PDXECE411T12/ECE411-Project/readme.md

# ECE 411 Team 12 
## RFID Smart Lock

### Fall 2020
### Authors: Miles Breslin, Miguel Higgins Moy, John Sharpe, Noah Page
