PDXECE411T12/ECE411-Project/EagleCAD/readme.md

Schematic forked from Adafruit's wonderful ESP8266 Huzzah PCB

<https://github.com/PDXECE411T12/ECE411-RFID-Lock-Eagle>
