PDXECE411T12/ECE411-Project/Homework Deliverables/Practicum/Three Project Ideas/CatFeeder.md

# Cat Feeder

Reservoir of food that opens based on an RFID chip's proximity. This will help deter cats from eating another cat's food.

Sensor: RFID
Actuator: Servo Motor
Processor: ESP8266
