PDXECE411T12/ECE411-Project/Homework Deliverables/Practicum/Three Project Ideas/GuitarPedal.md

# Guitar Pedal

A custom processor to modulate the frequency of the sound output by a guitar.

Sensor: Potentiometers
Actuator: Sound
Controller: ESP8266
