PDXECE411T12/ECE411-Project/Homework Deliverables/BlockDiagrams.md

# System Inputs/Outputs

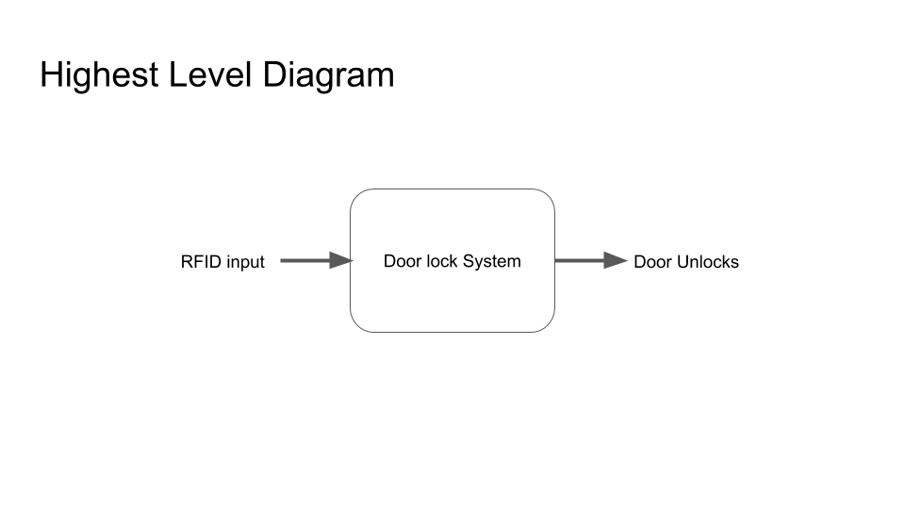
[picture p18: Homework Deliverables/imgs/BlockDiagram1.png]


# Interconnections of Subsystems

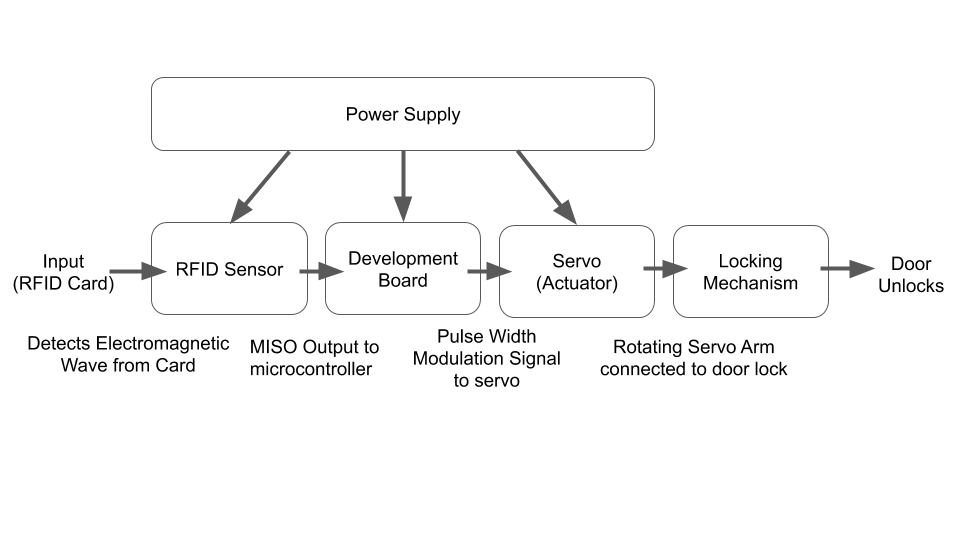
[picture p19: Homework Deliverables/imgs/BlockDiagram2.png]


# Subsystem Block Diagrams

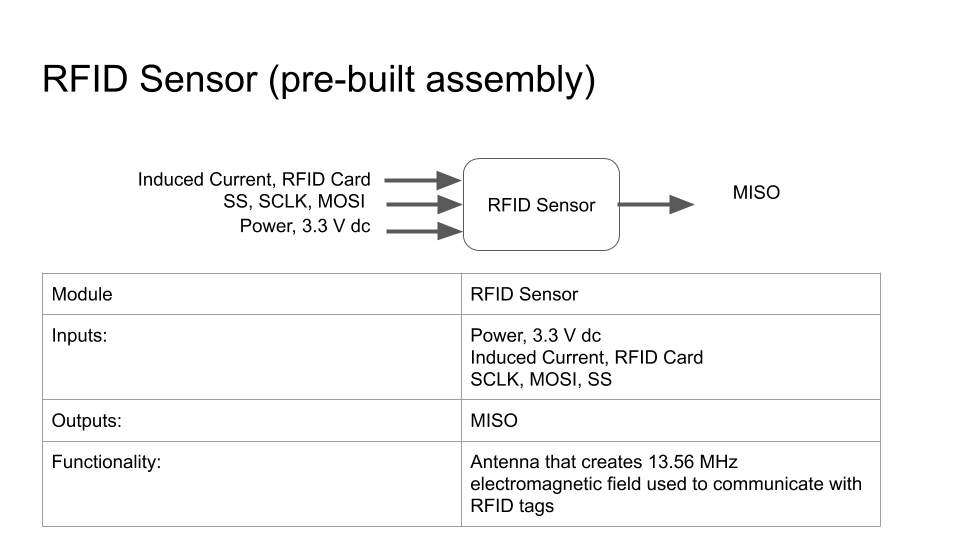
[picture p20: Homework Deliverables/imgs/BlockDiagram3.png]


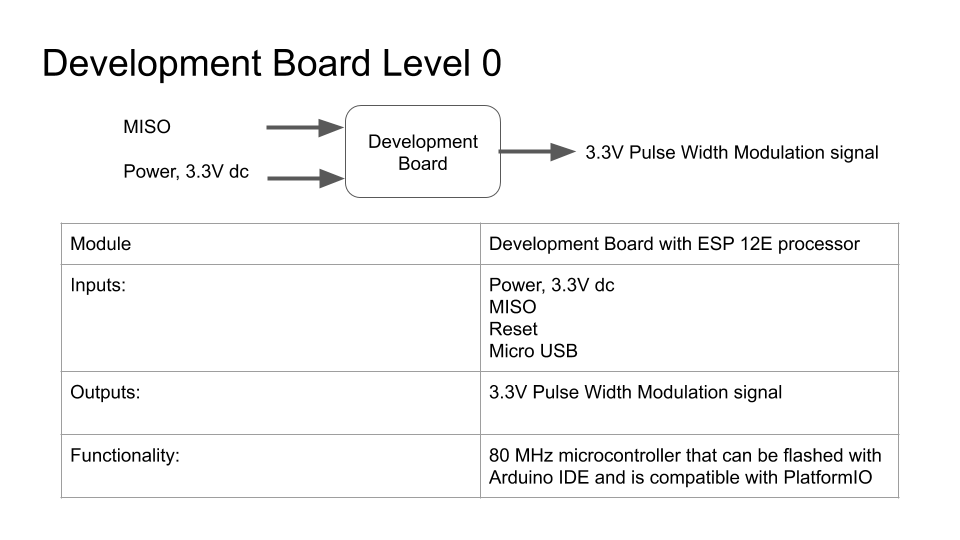
[picture p21: Homework Deliverables/imgs/BlockDiagram4.png]


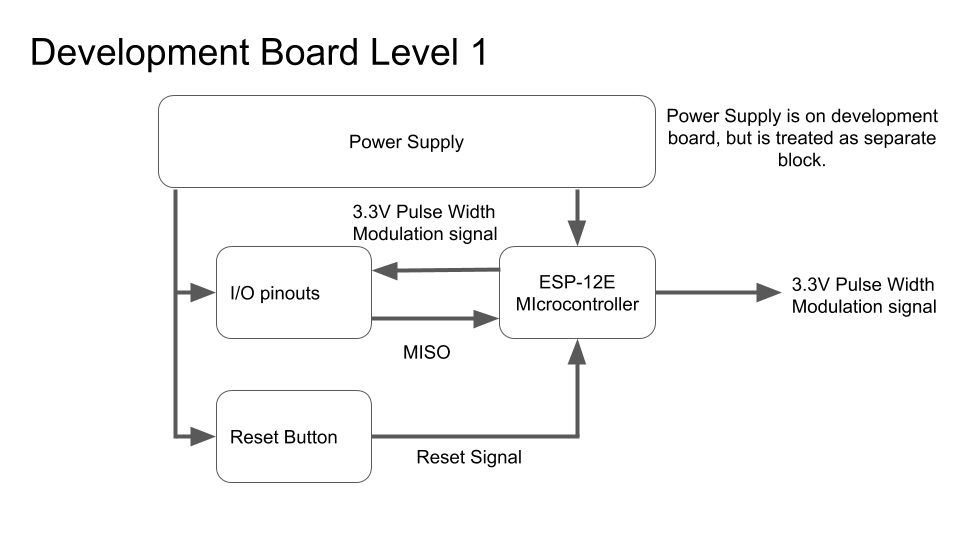
[picture p22: Homework Deliverables/imgs/BlockDiagram5.png]


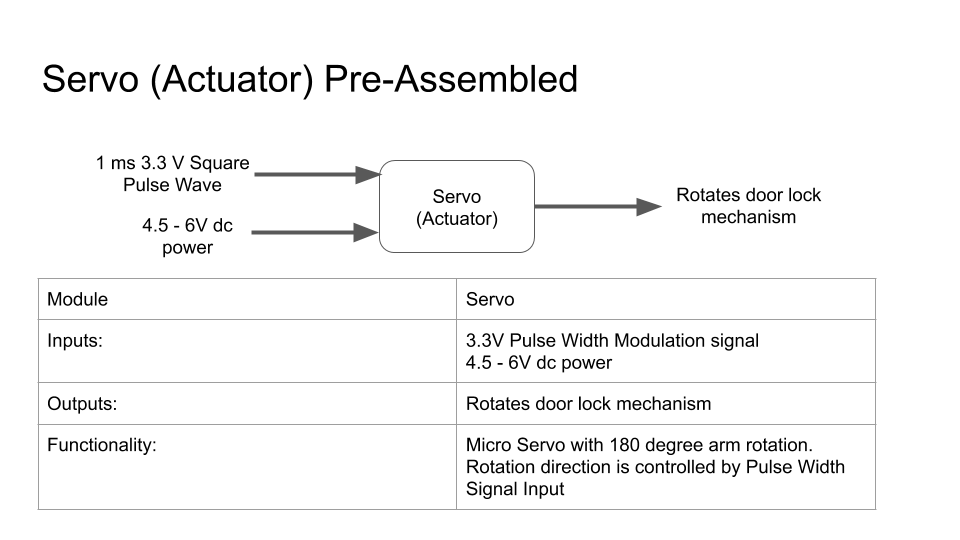
[picture p23: Homework Deliverables/imgs/BlockDiagram6.png]


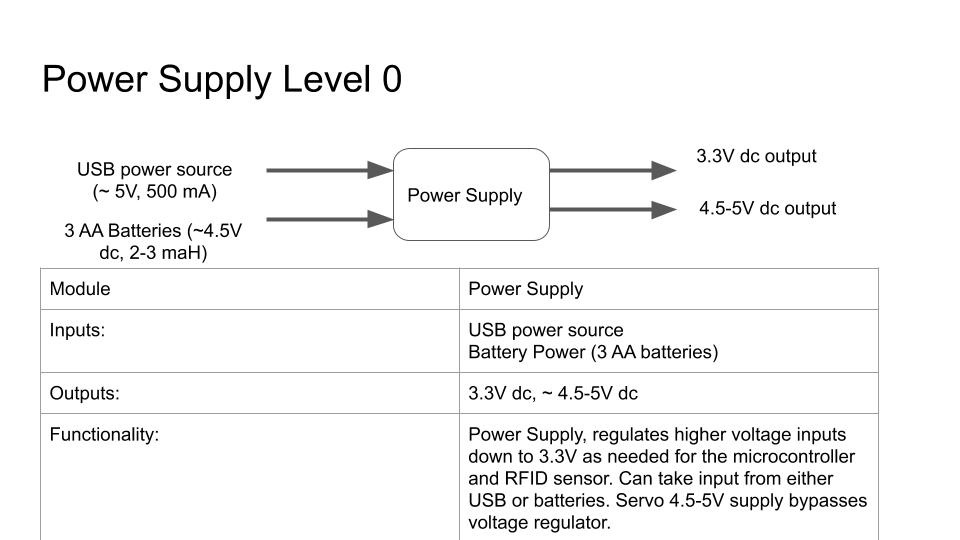
[picture p24: Homework Deliverables/imgs/BlockDiagram7.png]


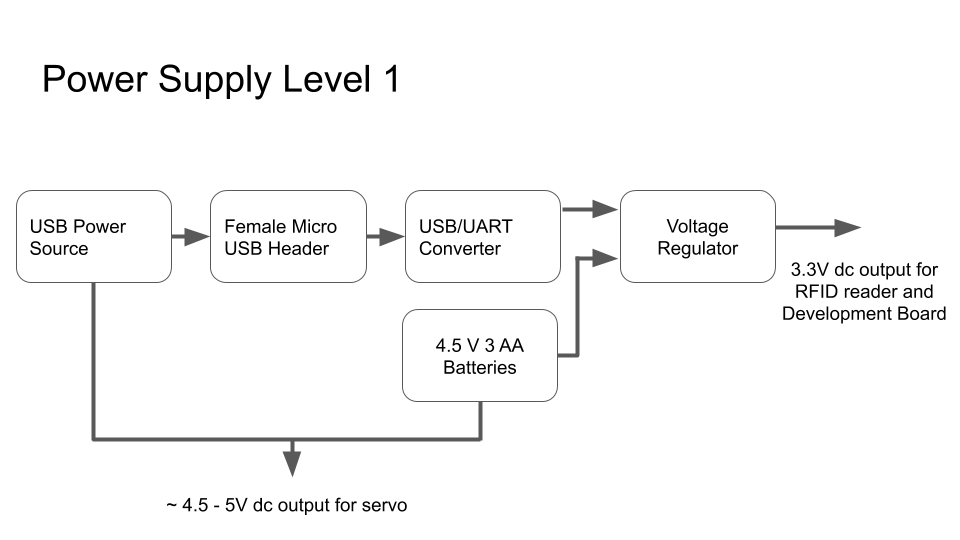
[picture p25: Homework Deliverables/imgs/BlockDiagram8.png]
