PDXECE411T12/ECE411-Project/3D CAD/Renders/c79d910a-2ed1-4fb5-9dcb-18d5553b62f3.PNG

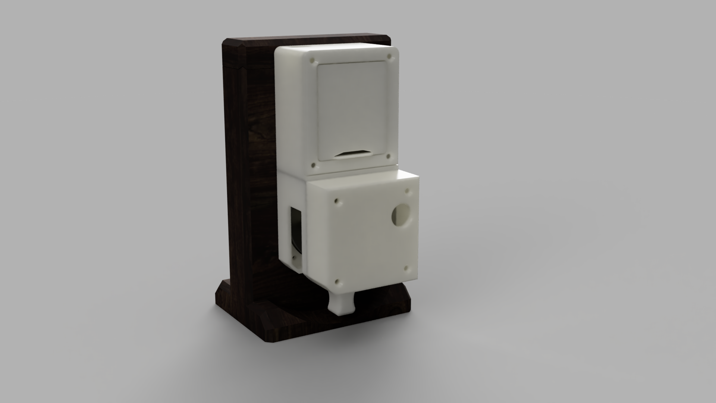
3D CAD/Renders/c79d910a-2ed1-4fb5-9dcb-18d5553b62f3.PNG
