PDXECE411T12/ECE411-Project/Development Pictures/PXL_20201015_190127888.jpg

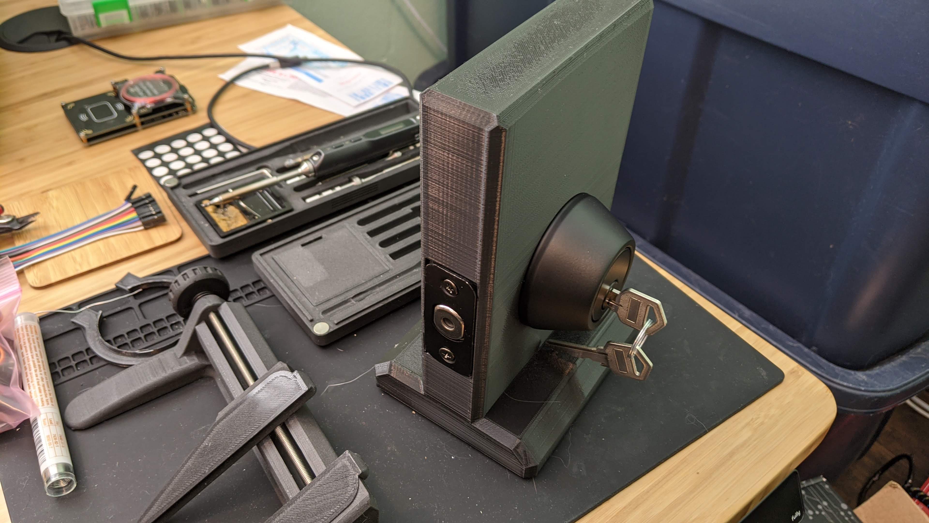
Development Pictures/PXL_20201015_190127888.jpg
