PDXECE411T12/ECE411-Project/Development Pictures/PXL_20201022_012917890.jpg

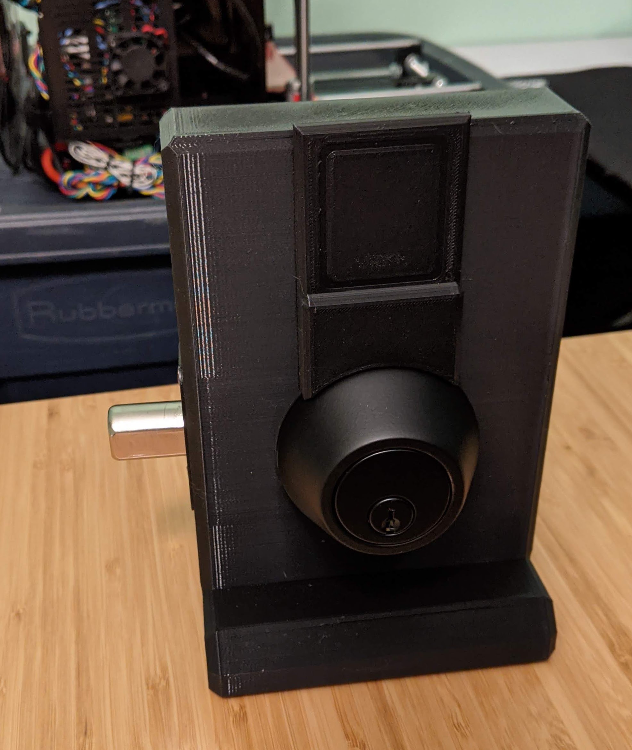
Development Pictures/PXL_20201022_012917890.jpg
