PDXECE411T12/ECE411-Project/Development Pictures/PXL_20201027_185949767.jpg

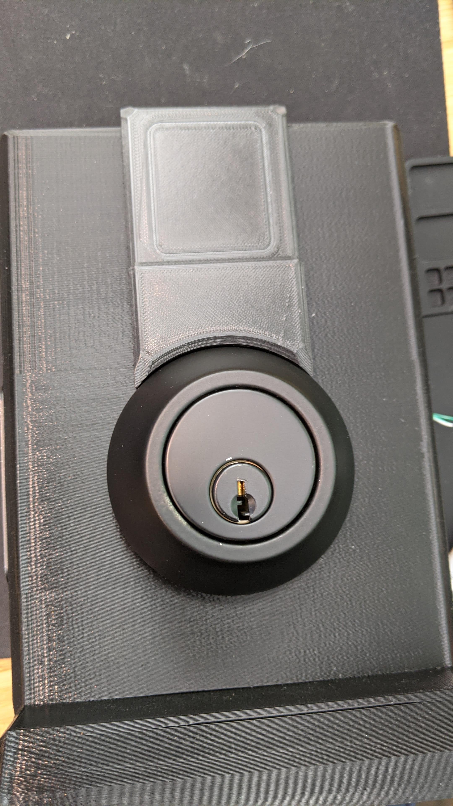
Development Pictures/PXL_20201027_185949767.jpg
