PDXECE411T12/ECE411-Project/Development Pictures/PXL_20201105_004521826.jpg

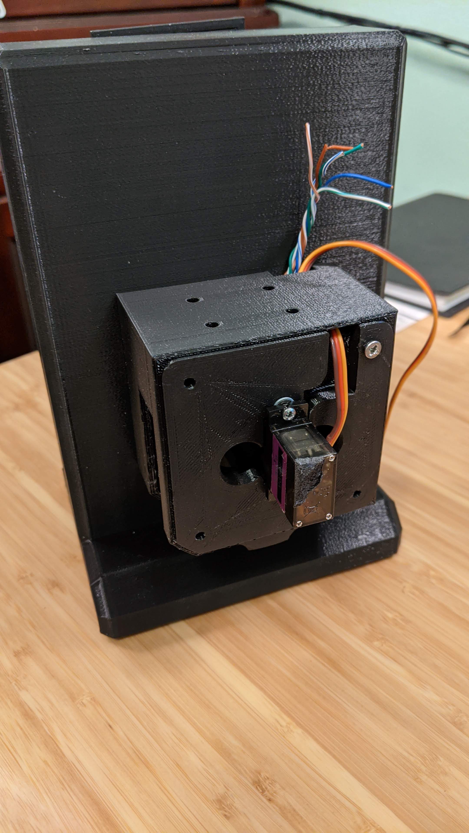
Development Pictures/PXL_20201105_004521826.jpg
