PDXECE411T12/ECE411-Project/Development Pictures/PXL_20201118_205450587.jpg

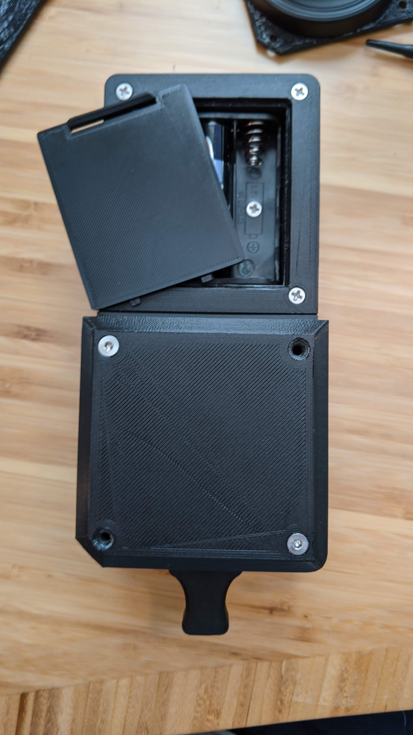
Development Pictures/PXL_20201118_205450587.jpg
