PDXECE411T12/ECE411-Project/Development Pictures/PXL_20201128_220356031.jpg

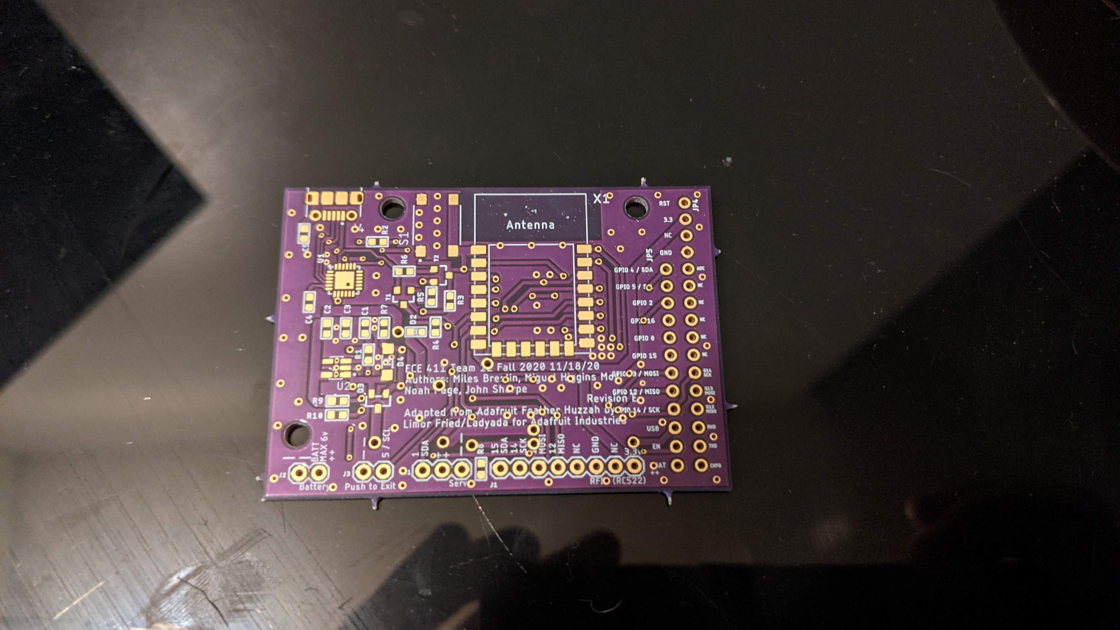
Development Pictures/PXL_20201128_220356031.jpg
