PDXECE411T12/ECE411-Project/Development Pictures/PXL_20201129_020343854.jpg

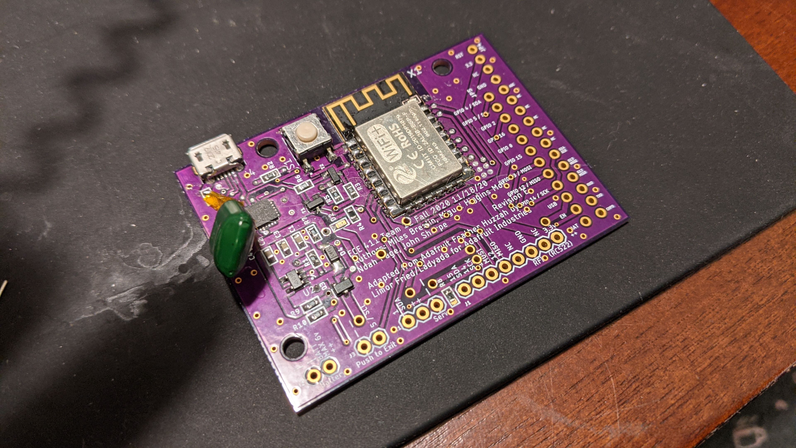
Development Pictures/PXL_20201129_020343854.jpg
