PDXECE411T12/ECE411-Project/Development Pictures/PXL_20201201_011239377.jpg

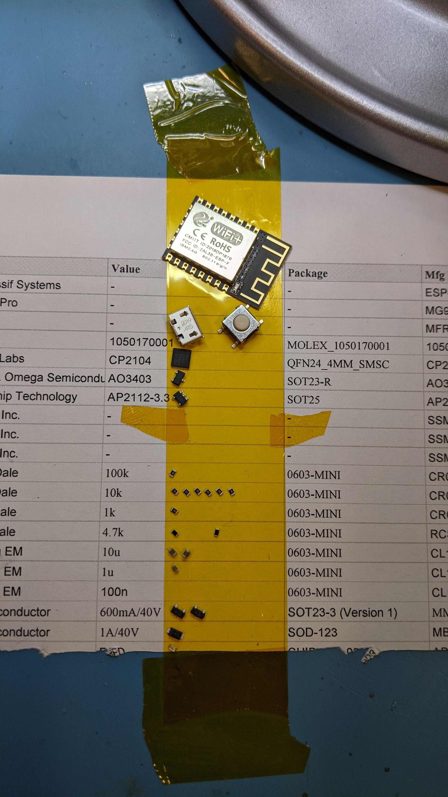
Development Pictures/PXL_20201201_011239377.jpg
