PDXECE411T12/ECE411-Project/Development Pictures/PXL_20201201_011239785.jpg

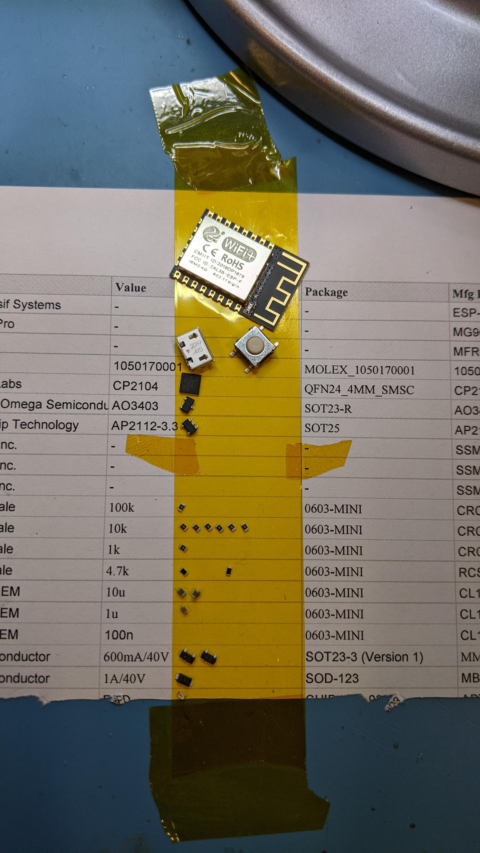
Development Pictures/PXL_20201201_011239785.jpg
