PDXECE411T12/ECE411-Project/Development Pictures/PXL_20201201_011246422.jpg

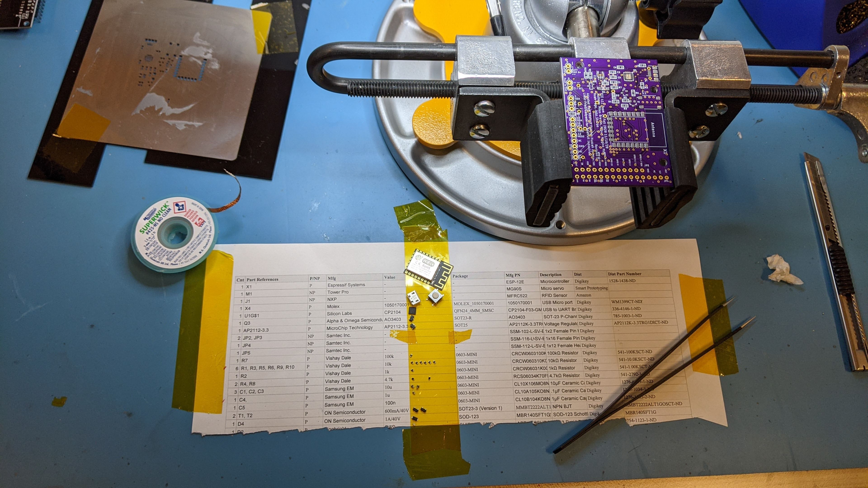
Development Pictures/PXL_20201201_011246422.jpg
