PDXECE411T12/ECE411-Project/Development Pictures/PXL_20201203_230125700.jpg

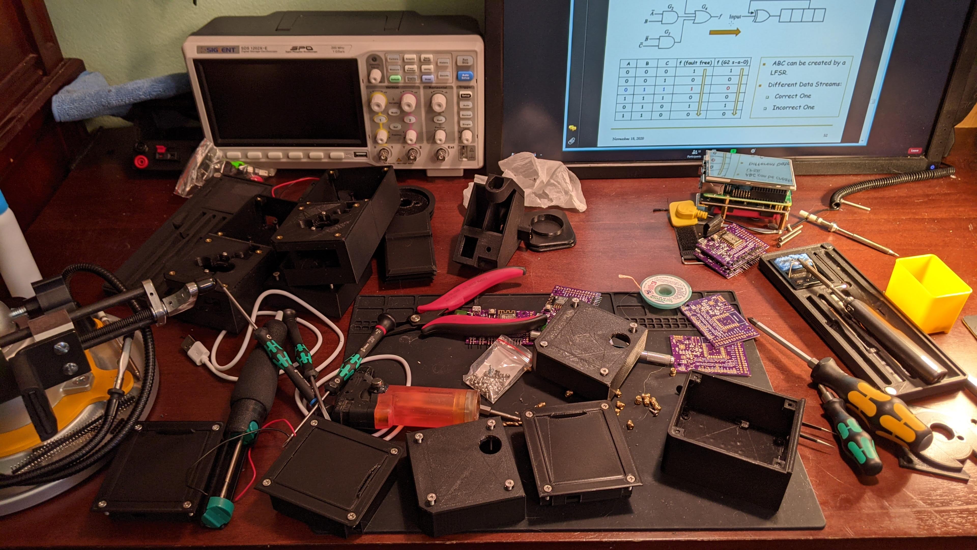
Development Pictures/PXL_20201203_230125700.jpg
