PDXECE411T12/ECE411-Project/Development Pictures/PXL_20201205_045559670.jpg

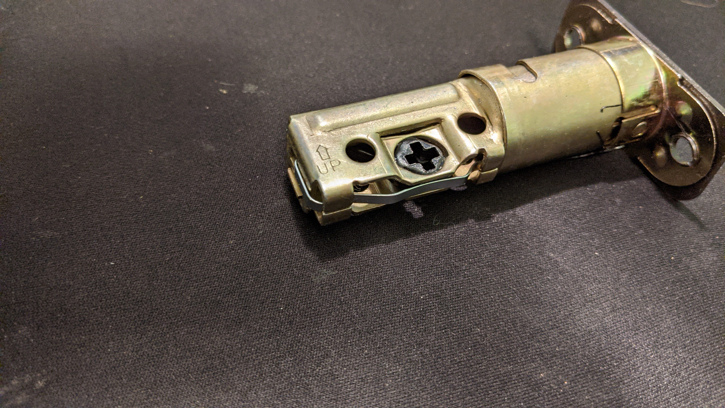
Development Pictures/PXL_20201205_045559670.jpg
