PDXECE411T12/ECE411-Project/Development Pictures/PXL_20201205_045744880.jpg

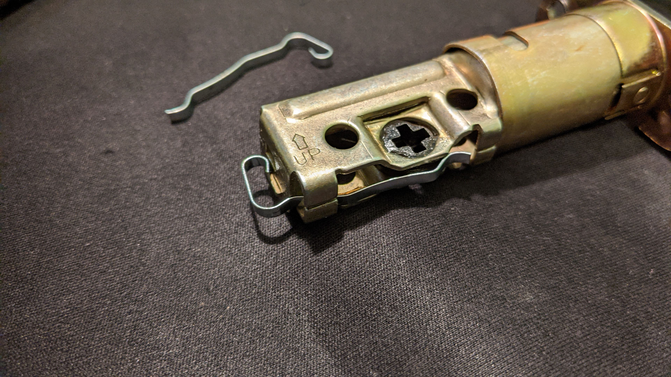
Development Pictures/PXL_20201205_045744880.jpg
