PDXECE411T12/ECE411-Project/Development Pictures/PXL_20201205_050712844.jpg

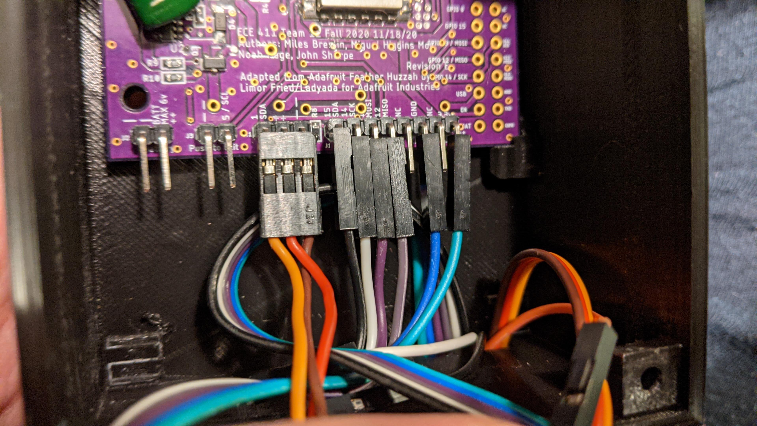
Development Pictures/PXL_20201205_050712844.jpg
