PDXECE411T12/ECE411-Project/Development Pictures/PXL_20201206_013354883.jpg

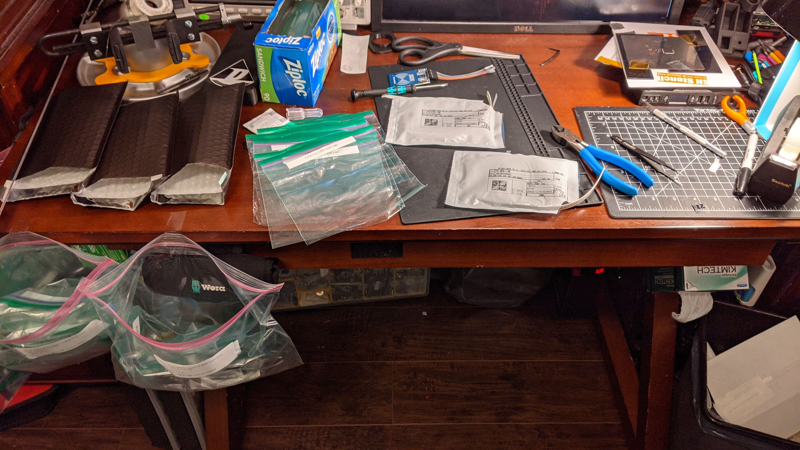
Development Pictures/PXL_20201206_013354883.jpg
