PDXECE411T12/ECE411-Project/Development Pictures/PXL_20201206_013933992.jpg

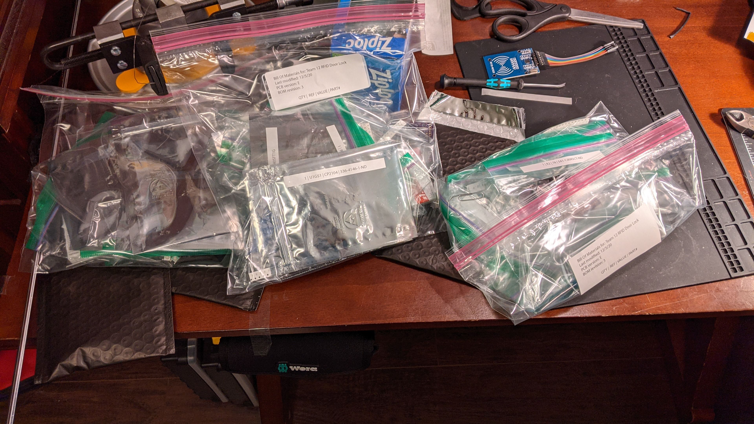
Development Pictures/PXL_20201206_013933992.jpg
