PDXECE411T12/ECE411-Project/Development Pictures/PXL_20201208_233832981.jpg

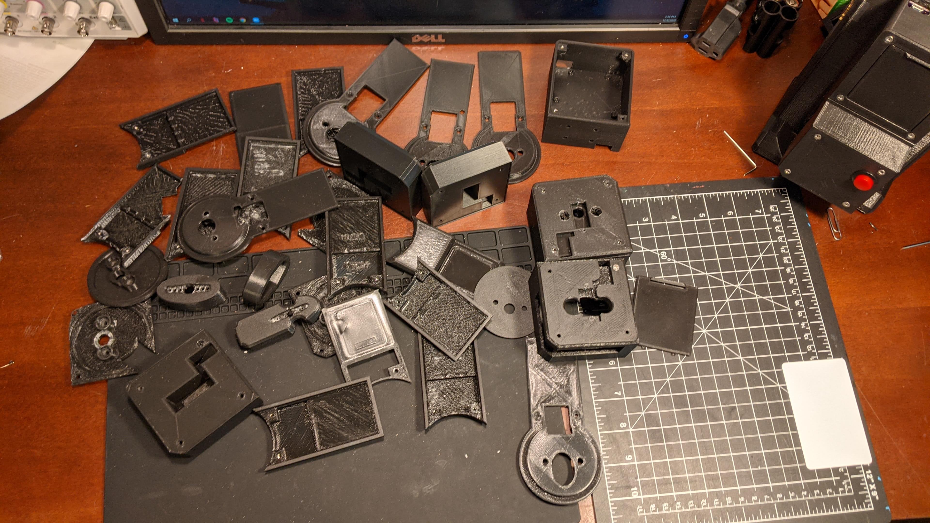
Development Pictures/PXL_20201208_233832981.jpg
