PDXECE411T12/ECE411-Project/Development Pictures/PXL_20201209_034233728.jpg

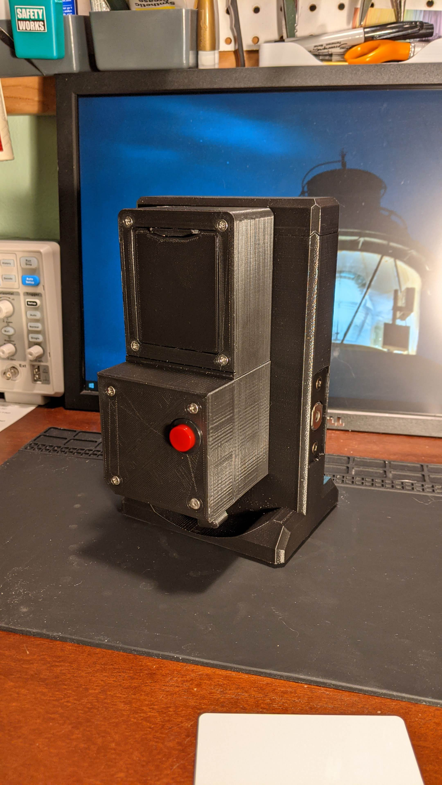
Development Pictures/PXL_20201209_034233728.jpg
