PDXECE411T12/ECE411-Project/Development Pictures/PXL_20201209_034239419.jpg

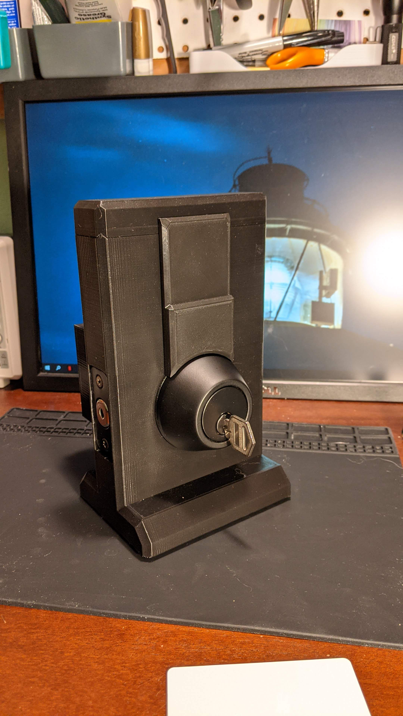
Development Pictures/PXL_20201209_034239419.jpg
