PDXECE411T12/ECE411-Project/Development Pictures/PXL_20210108_050151601.jpg

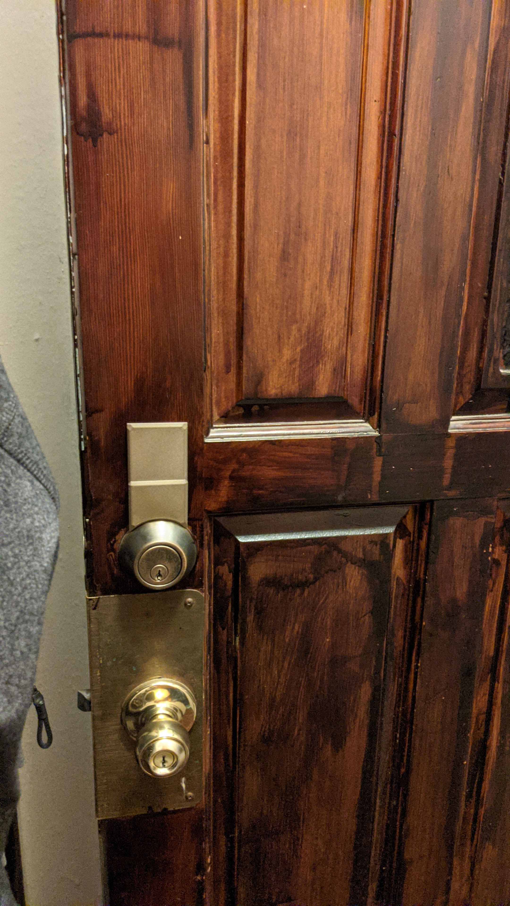
Development Pictures/PXL_20210108_050151601.jpg
