PDXECE411T12/ECE411-Project/EagleCAD/OSH Park Images/8f41cf0d4bf84ae36854d8a8b0df9540.png

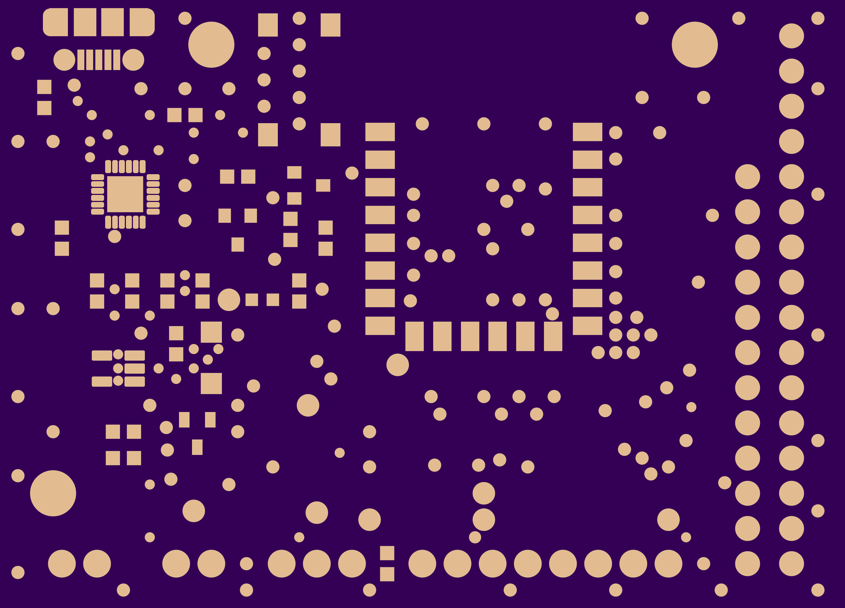
EagleCAD/OSH Park Images/8f41cf0d4bf84ae36854d8a8b0df9540.png
