PDXECE411T12/ECE411-Project/EagleCAD/OSH Park Images/348e3925779ca9b16d00923657f37588.png

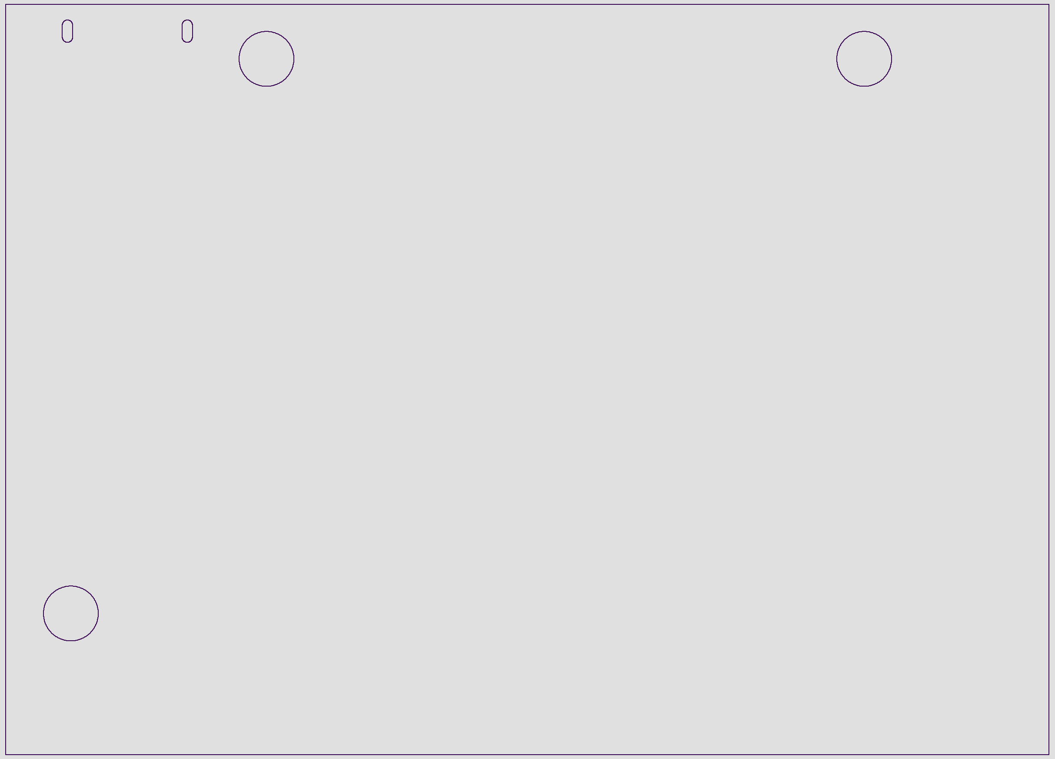
EagleCAD/OSH Park Images/348e3925779ca9b16d00923657f37588.png
