PDXECE411T12/ECE411-Project/EagleCAD/OSH Park Images/751e521c94ff2c1ccbff779e9073be98.png

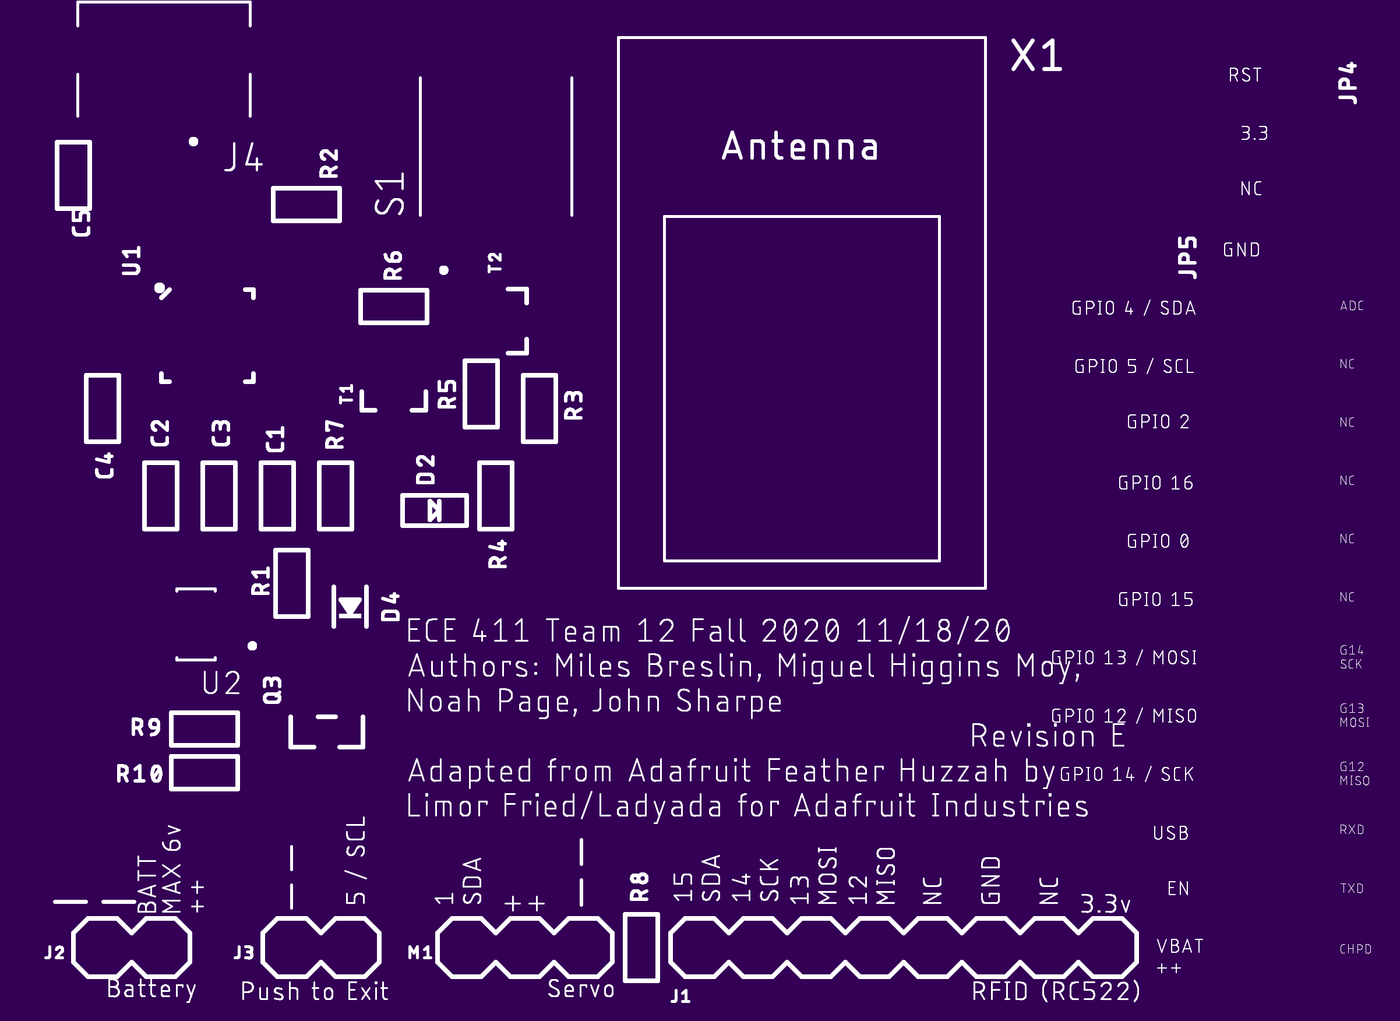
EagleCAD/OSH Park Images/751e521c94ff2c1ccbff779e9073be98.png
