PDXECE411T12/ECE411-Project/EagleCAD/OSH Park Images/3511a0de9b1d28798516a4e4f3d8dc5f.png

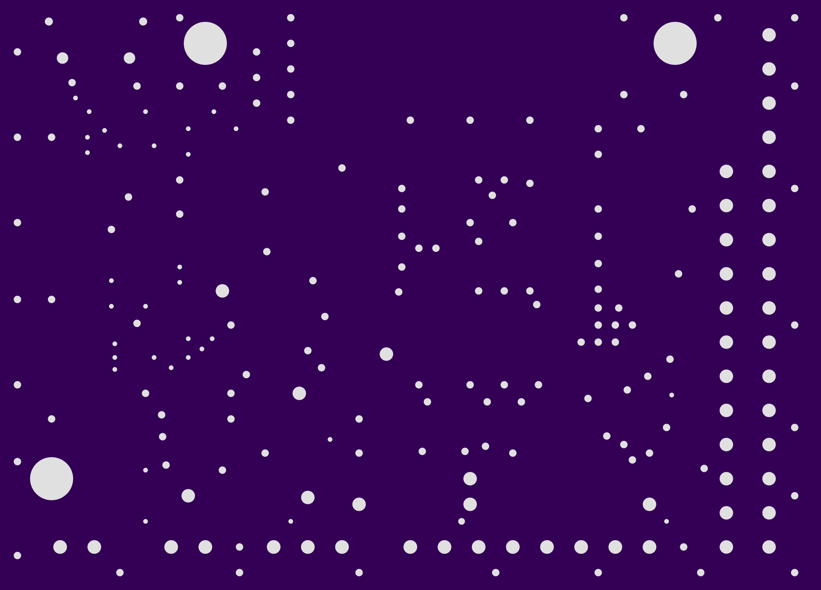
EagleCAD/OSH Park Images/3511a0de9b1d28798516a4e4f3d8dc5f.png
