PDXECE411T12/ECE411-Project/EagleCAD/OSH Park Images/699818b9b4631fd348fab63cceb37a54.png

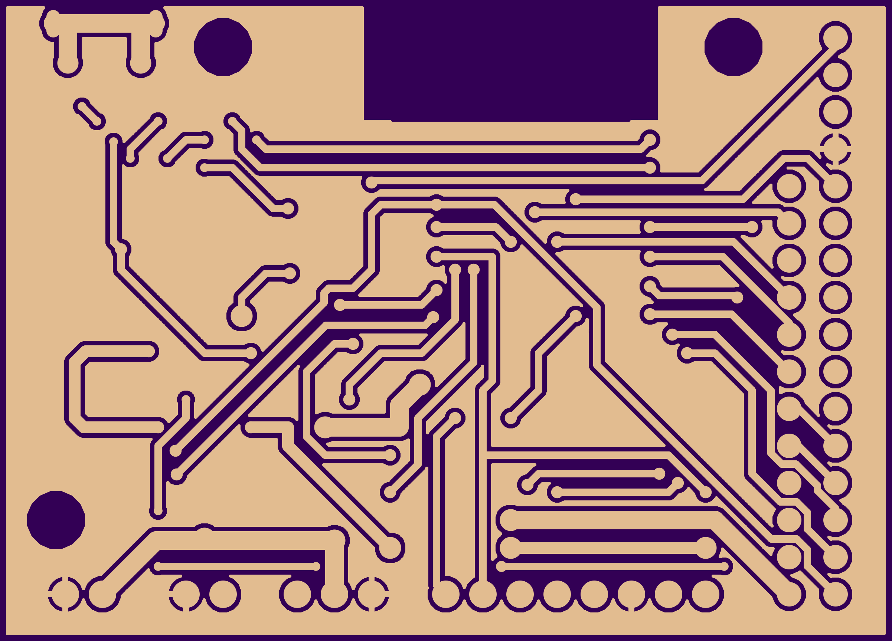
EagleCAD/OSH Park Images/699818b9b4631fd348fab63cceb37a54.png
