PDXECE411T12/ECE411-Project/EagleCAD/OSH Park Images/c2b34a3a01c194c366f5438f7fead9e8.png

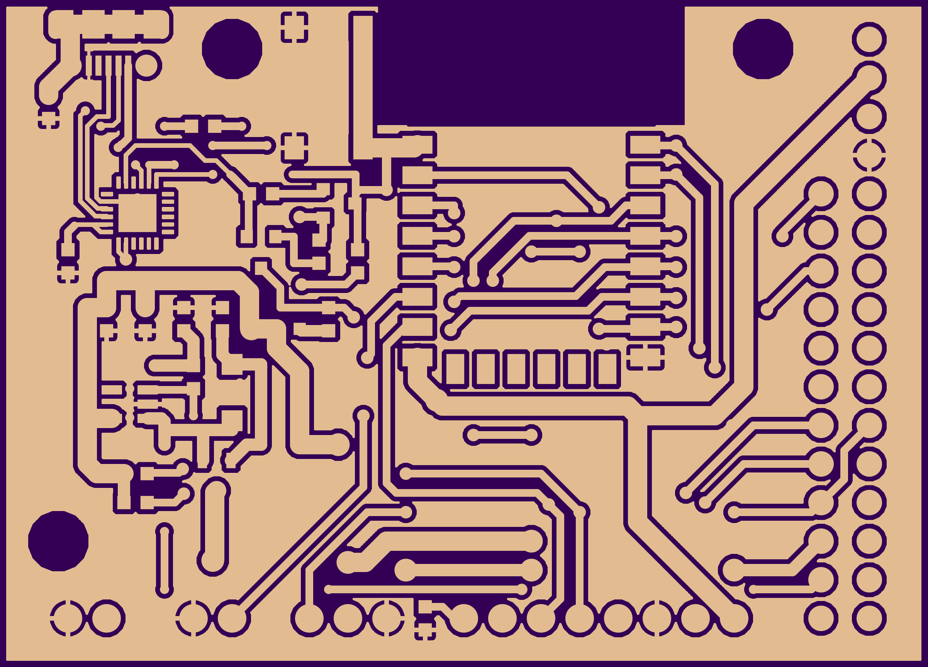
EagleCAD/OSH Park Images/c2b34a3a01c194c366f5438f7fead9e8.png
