PDXECE411T12/ECE411-Project/EagleCAD/OSH Park Images/cb4d32523cf9ccf9acd046136495eacc.png

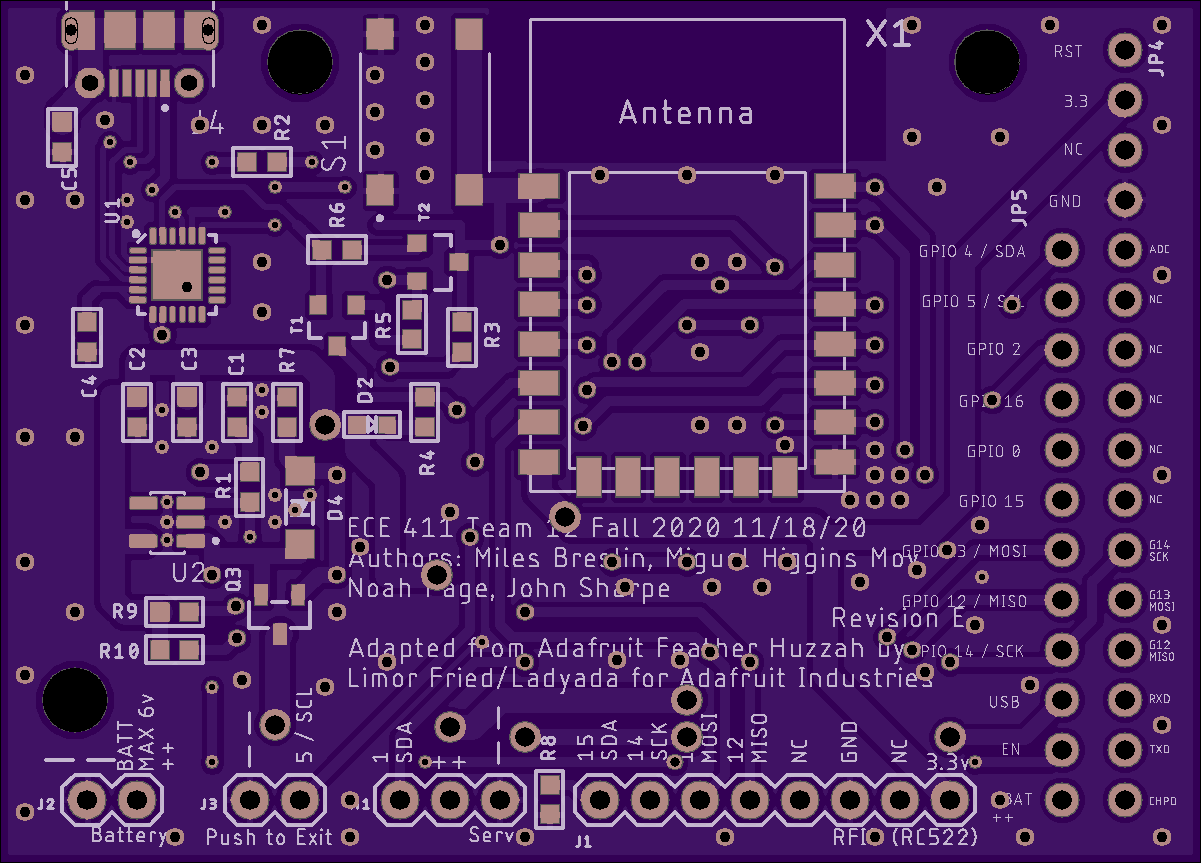
EagleCAD/OSH Park Images/cb4d32523cf9ccf9acd046136495eacc.png
