PDXECE411T12/ECE411-Project/EagleCAD/OSH Park Images/f93b67e7af90ffe62f34f204679cd5a4.png

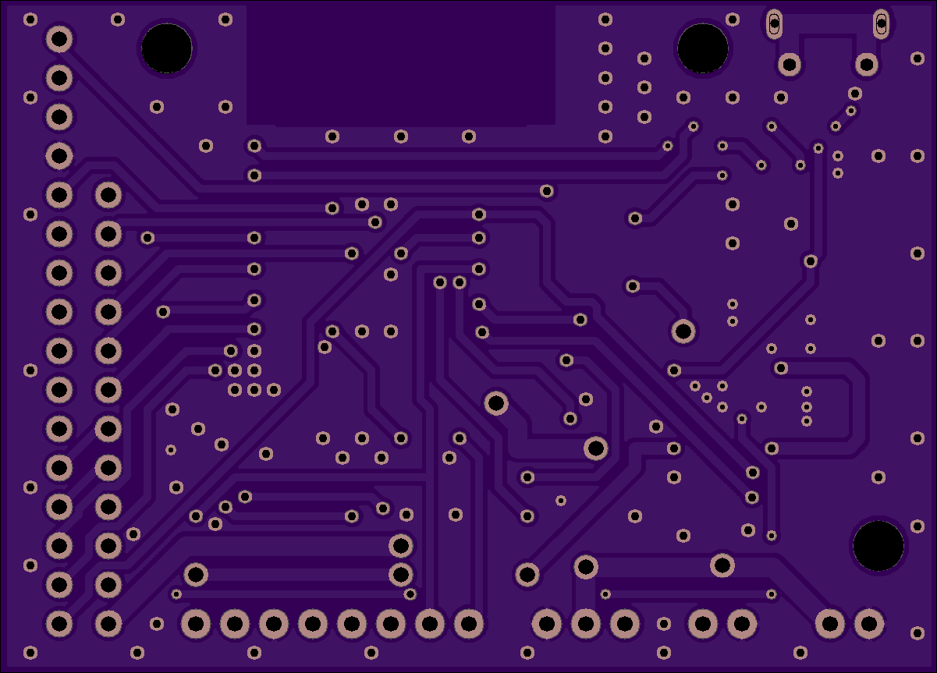
EagleCAD/OSH Park Images/f93b67e7af90ffe62f34f204679cd5a4.png
