PDXECE411T12/ECE411-Project/Homework Deliverables/imgs/ProjectSchedule.png

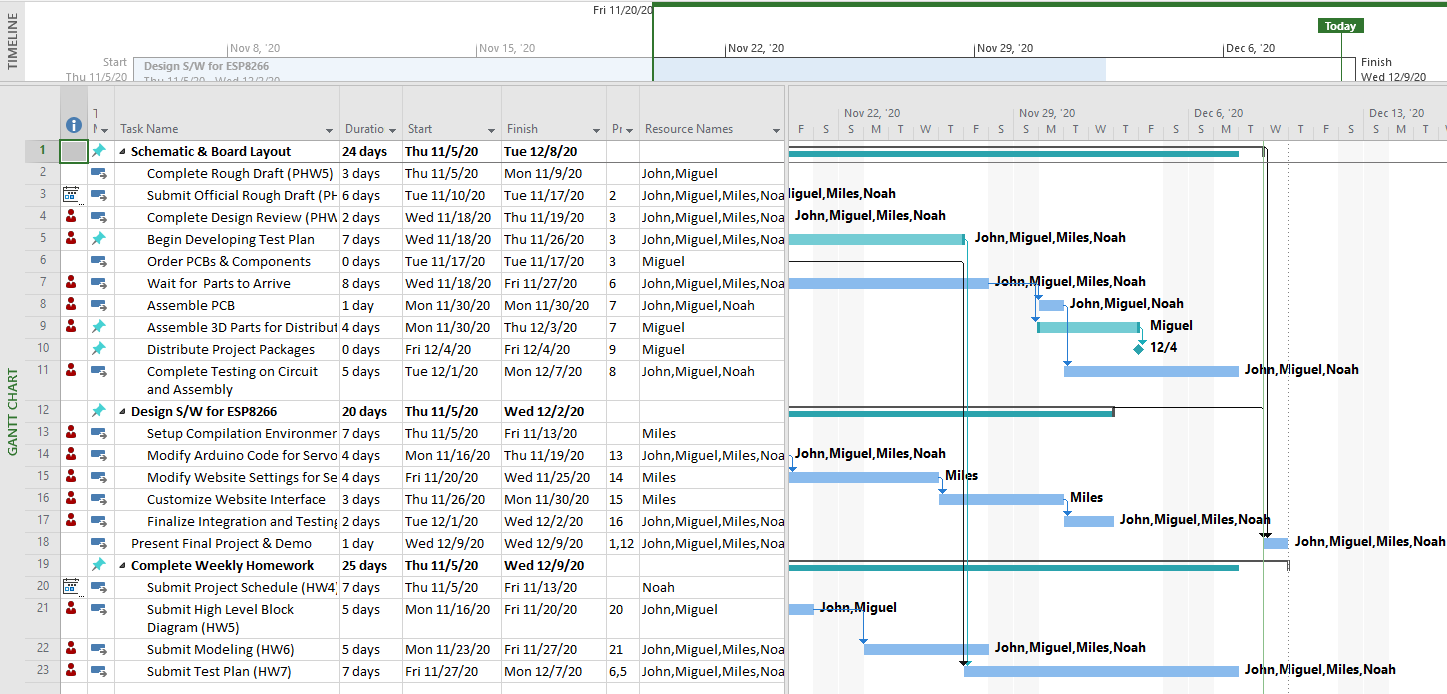
Homework Deliverables/imgs/ProjectSchedule.png
