PDXECE411T12/ECE411-Project/Homework Deliverables/Practicum/imgs/ProjectSchedule-page-001b.jpg

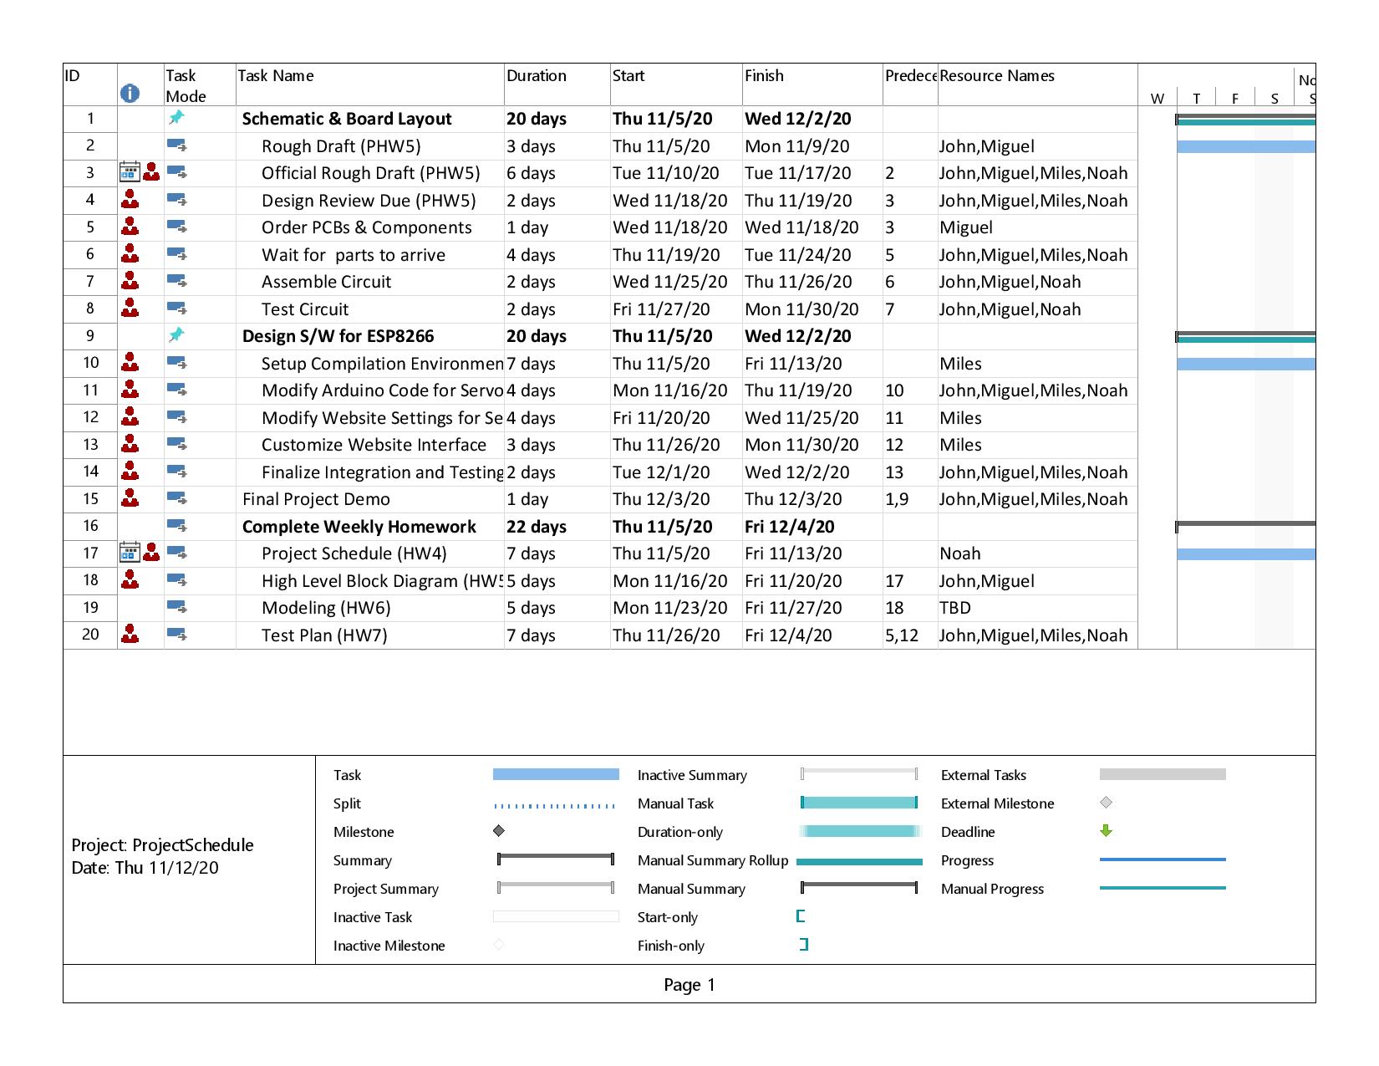
Homework Deliverables/Practicum/imgs/ProjectSchedule-page-001b.jpg
