PDXECE411T12/ECE411-Project/Homework Deliverables/Practicum/imgs/ProjectSchedule-page-002b.jpg

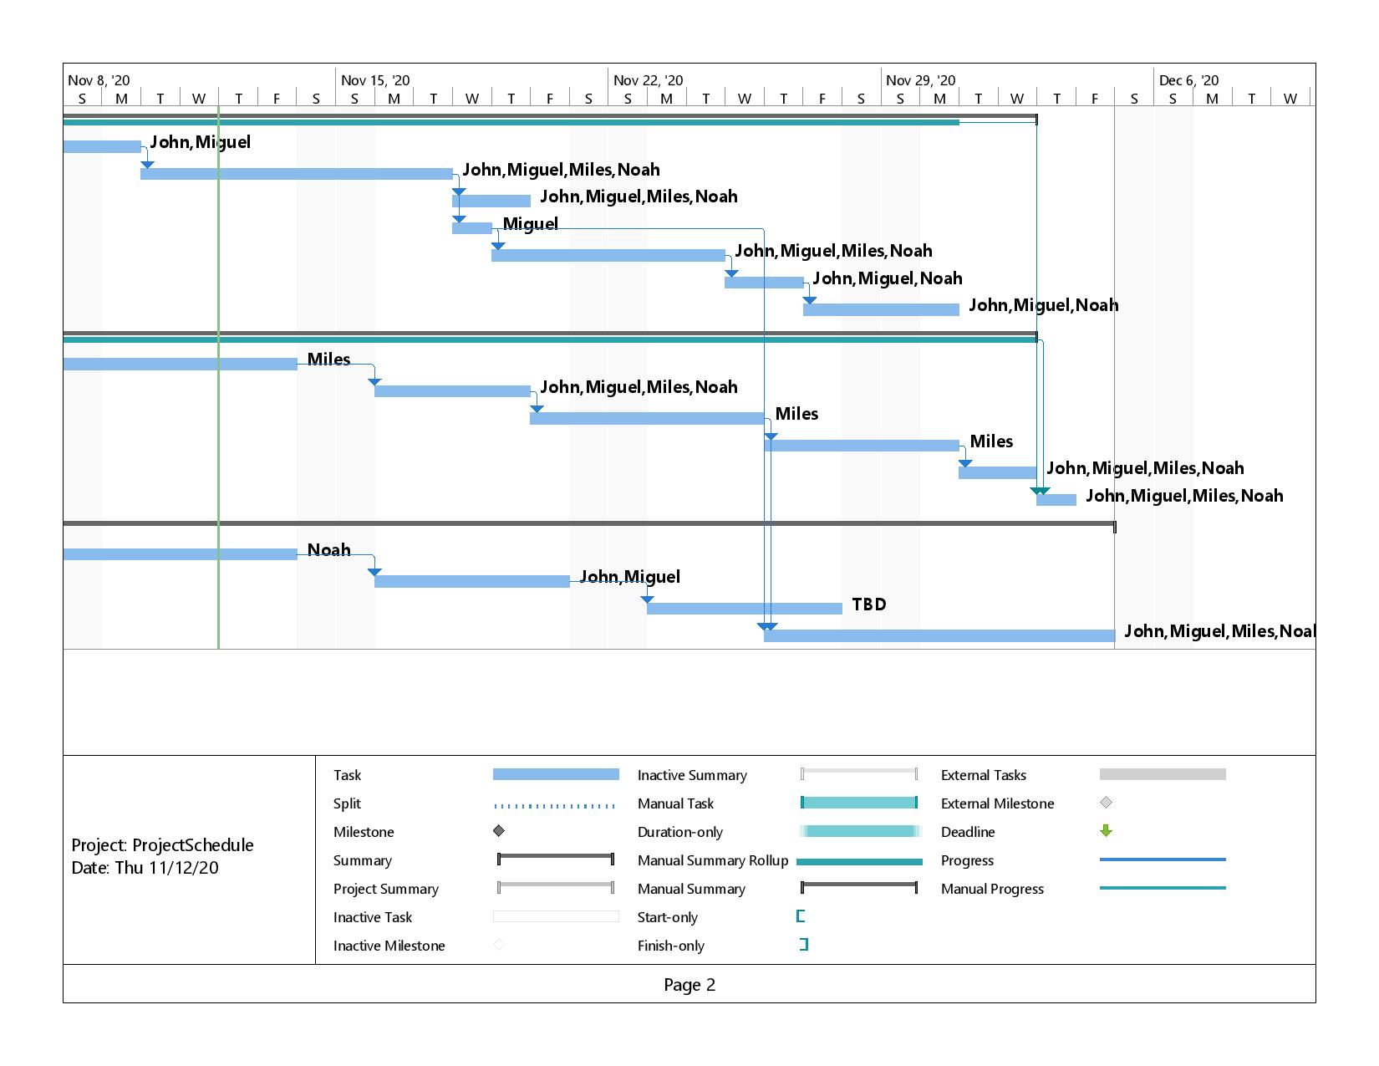
Homework Deliverables/Practicum/imgs/ProjectSchedule-page-002b.jpg
