PDXECE411T12/ECE411-Project/ProjectSchedule2.jpg

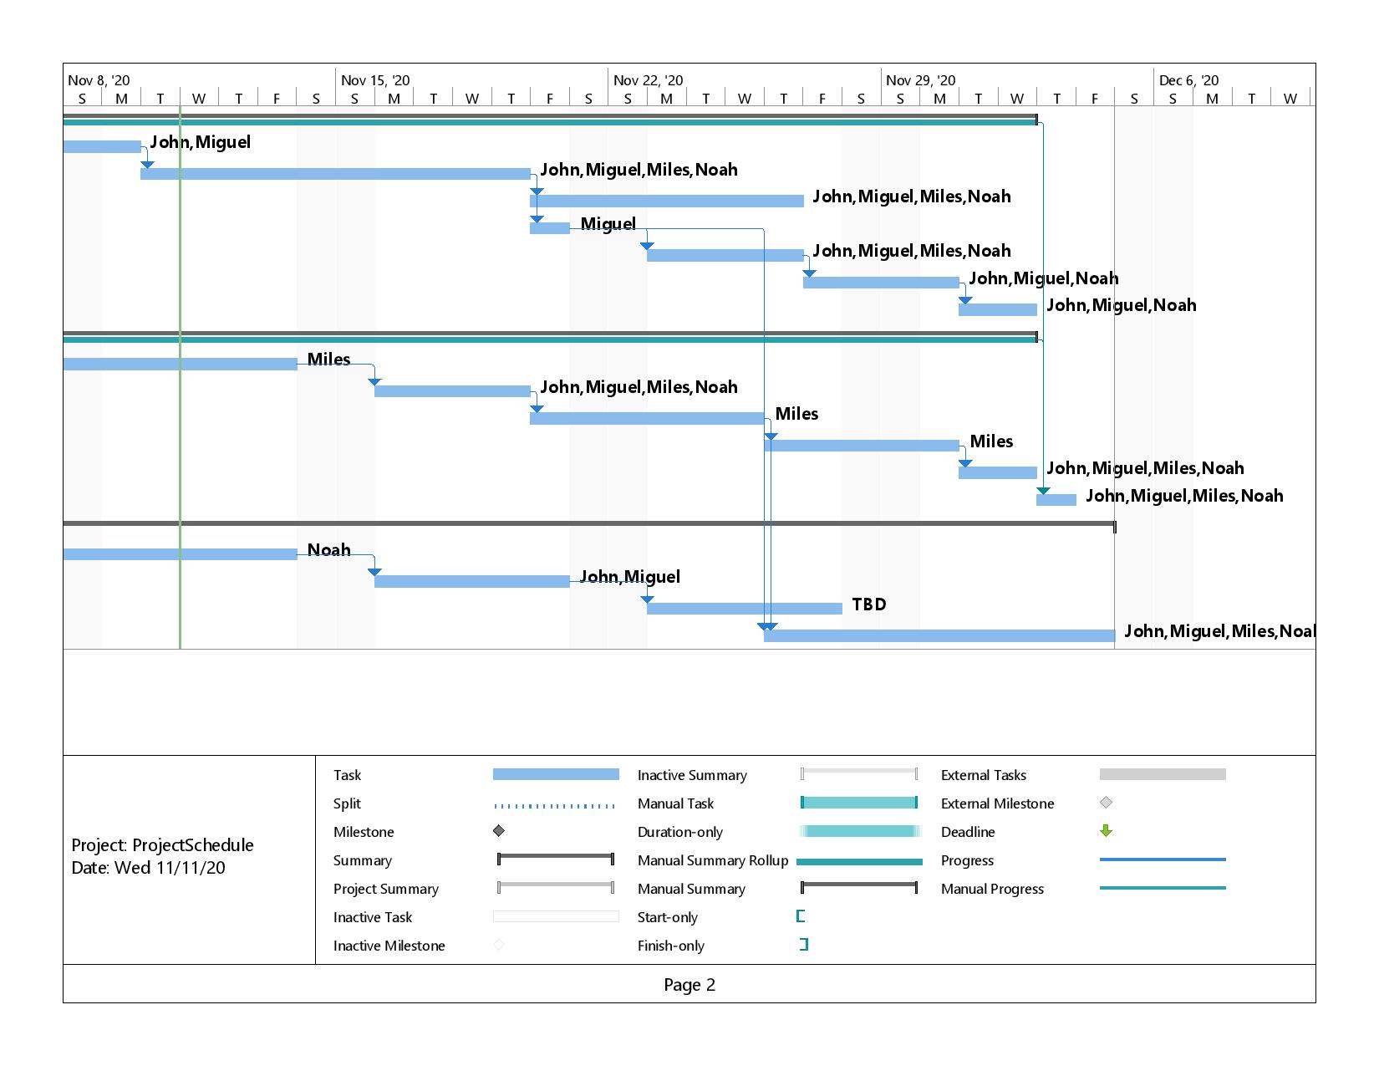
ProjectSchedule2.jpg
