PDXECE411T12/ECE411-Project/BOM.xlsx

Bill Of Materials for: Team 12 RFID Door Lock
Last modified: 1/8/21
PCB version: F
BOM revision: 5 |  | P/NP | Place/Not Place (components marked NP are not stuffed on the board)
 |  |  |  |  |  |  |  |  |  |  |  |  | Combined Info for Bag Labels
Cnt | Part References | P/NP | Mfg | Value | Package | Mfg PN | Description | Dist | Dist Part Number | Link | Cost Ea. | Cost Total
1 | - | NP | OshPark | - | - | - | OshPark PCB | OshPark | - | - | $6.92 | $6.92 | QTY | REF | VALUE | PART#
1 | X1 | P | Espressif Systems | - | - | ESP-12E | Microcontroller | Digikey | 1528-1438-ND | https://www.digikey.com/en/products/detail/adafruit-industries-llc/2491/5761206 | $6.95 | $6.95
1 | M1 | NP | Tower Pro | - | - | MG90S | Micro servo | Smart Prototyping |  | https://www.smart-prototyping.com/MG90S-9g-metal-gear-digital-servo.html | $4.99 | $4.99 | 1 | X1 | - | 1528-1438-ND
1 | J1 | NP | NXP | - | - | MFRC522 | RFID Sensor | Amazon |  | https://www.amazon.com/MFRC-522-Reader-Inductive-Module-13-56MHz/dp/B07TYSF18Q | $1.99 | $1.99 | 1 | M1 | -
1 | X4 | P | Molex | 1050170001 | MOLEX_1050170001 | 1050170001 | USB Micro port | Digikey | WM1399CT-ND‎ | https://www.digikey.com/en/products/detail/molex,-llc/1050170001/2350885 | $0.69 | $0.69 | 1 | J1 | -
1 | U1G$1 | P | Silicon Labs | CP2104 | QFN24_4MM_SMSC | CP2104-F03-GM | USB to UART Bridge Controller | Digikey | 336-4146-1-ND | https://www.digikey.com/en/products/detail/silicon-labs/CP2104-F03-GMR/4069045 | $1.65 | $1.65 | 1 | X4 | 1050170001 | WM1399CT-ND‎
1 | Q3 | P | Alpha & Omega Semiconductor Inc. | AO3403 | SOT23-R | AO3403 | SOT-23 P-Channel MOSFET | Digikey | 785-1003-1-ND | https://www.digikey.com/en/products/detail/alpha-omega-semiconductor-inc/AO3403/1855775 | $0.28 | $0.28 | 1 | U1G$1 | CP2104 | 336-4146-1-ND
1 | AP2112-3.3 | P | MicroChip Technology | AP2112-3.3 | SOT25 | AP2112K-3.3TRG1 | Voltage Regulator | Digikey | AP2112K-3.3TRG1DICT-ND | https://www.digikey.com/en/products/detail/diodes-incorporated/AP2112K-3-3TRG1/4470746 | $0.36 | $0.36 | 1 | Q3 | AO3403 | 785-1003-1-ND
2 | JP2, JP3 | NP | Samtec Inc. | - | - | SSM-102-L-SV-BE | 1x2 Female Pin Header | Digikey |  | https://www.digikey.com/en/products/detail/samtec-inc/SSM-102-L-SV-BE/7859716 | $0.93 | $1.86 | 1 | AP2112-3.3 | AP2112-3.3 | AP2112K-3.3TRG1DICT-ND
1 | JP4 | NP | Samtec Inc. | - | - | SSM-116-L-SV-BE | 1x16 Female Pin Header | Digikey |  | https://www.digikey.com/en/products/detail/samtec-inc/SSM-116-L-SV-BE/6693187 | $2.95 | $2.95 | 2 | JP2, JP3 | -
1 | JP5 | NP | Samtec Inc. | - | - | SSM-112-L-SV-BE | 1x12 Female Header | Digikey |  | https://www.digikey.com/en/products/detail/samtec-inc/SSM-112-L-SV-BE/7860545 | $2.38 | $2.38 | 1 | JP4 | -
1 | R7 | P | Vishay Dale | 100k | 0603-MINI | CRCW0603100KFKEAHP‎ | 100kΩ Resistor | Digikey | 541-100KSCT-ND | https://www.digikey.com/en/products/detail/CRCW0603100KFKEAHP/541-100KSCT-ND/2222790?itemSeq=345258140 | $0.05 | $0.05 | 1 | JP5 | -
6 | R1, R3, R5, R6, R9, R10, R11 | P | Vishay Dale | 10k | 0603-MINI | CRCW060310K0FKEAHP‎ | 10kΩ Resistor | Digikey | 541-10.0KSCT-ND | https://www.digikey.com/en/products/detail/CRCW060310K0FKEAHP/541-10.0KSCT-ND/2222780?itemSeq=345258137 | $0.05 | $0.30 | 1 | R7 | 100k | 541-100KSCT-ND
1 | R2 | P | Vishay Dale | 1k | 0603-MINI | CRCW06031K00FKEAHP‎ | 1kΩ Resistor | Digikey | 541-1.00KSCT-ND | https://www.digikey.com/en/products/detail/CRCW06031K00FKEAHP/541-1.00KSCT-ND/2222766?itemSeq=345258145 | $0.05 | $0.05 | 6 | R1, R3, R5, R6, R9, R10, R11 | 10k | 541-10.0KSCT-ND
2 | R4, R8 | P | Vishay Dale | 4.7k | 0603-MINI | RCS06034K70FKEA‎ | 4.7kΩ Resistor | Digikey | 541-2792-1-ND | https://www.digikey.com/en/products/detail/RCS06034K70FKEA/541-2792-1-ND/5867085?itemSeq=345258142 | $0.04 | $0.08 | 1 | R2 | 1k | 541-1.00KSCT-ND
3 | C1, C2, C3 | P | Samsung EM | 10u | 0603-MINI | CL10X106MO8NRNC | 10µF Ceramic Capacitor | Digikey | 1276-6769-1-ND | https://www.digikey.com/en/products/detail/CL10X106MO8NRNC/1276-6769-1-ND/5961628?itemSeq=345262593 | $0.11 | $0.33 | 2 | R4, R8 | 4.7k | 541-2792-1-ND
1 | C4, | P | Samsung EM | 1u | 0603-MINI | CL10A105KO8NNNC | .1µF Ceramic Capacitor | Digikey | 1276-1034-1-ND | https://www.digikey.com/en/products/detail/CL10A105KO8NNNC/1276-1034-1-ND/3889120?itemSeq=345262622 | $0.02 | $0.02 | 3 | C1, C2, C3 | 10u | 1276-6769-1-ND
1 | C5 | P | Samsung EM | 100n | 0603-MINI | CL10B104KO8NNNC | 1µF Ceramic Capacitor | Digikey | 1276-1005-2-ND | https://www.digikey.com/en/products/detail/samsung-electro-mechanics/CL10B104KO8NNNC/3889091 | $0.01 | $0.01 | 1 | C4, | 1u | 1276-1034-1-ND
2 | T1, T2 | P | ON Semiconductor | 600mA/40V | SOT23-3 (Version 1) | MMBT2222ALT1G | NPN BJT | Digikey | MMBT2222ALT1GOSCT-ND | https://www.digikey.com/en/products/detail/MMBT2222ALT1G/MMBT2222ALT1GOSCT-ND/1139806?itemSeq=345263075 | $0.12 | $0.24 | 1 | C5 | 100n | 1276-1005-2-ND
1 | D4 | P | ON Semiconductor | 1A/40V | SOD-123 | MBR140SFT1G‎ | SOD-123 Schottky diode | Digikey | MBR140SFT1G | https://www.digikey.com/en/products/detail/on-semiconductor/MBR140SFT1G/918583 | $0.29 | $0.29 | 2 | T1, T2 | 600mA/40V | MMBT2222ALT1GOSCT-ND
1 | D2 | P | Kingbright | RED | CHIPLED_0603 | APT1608SURCK | 0603 Red LED | Digikey | 754-1123-1-ND | https://www.digikey.com/en/products/detail/kingbright/APT1608SURCK/1747522 | $0.21 | $0.21 | 1 | D4 | 1A/40V | MBR140SFT1G
1 | SW1 | P | Omron Electronics Inc-EMC Div | BB3S-1000 |  | BB3S-1000 | Tactile Switch | Digikey | SW415-ND | https://www.digikey.com/en/products/detail/omron-electronics-inc-emc-div/B3S-1000/20686 | $0.63 | $0.63 | 1 | D2 | RED | 754-1123-1-ND
3 | - | NP | Eneloop | AA - 1200mah | - | BK-3MCCA16FA | AA Batteries | Amazon | B00JHKSN4O | https://www.amazon.com/Panasonic-BK-3MCCA16FA-eneloop-Pre-Charged-Rechargeable/dp/B00JHKSN4O/ | $2.59 | $7.77 | 1 | SW1 | BB3S-1000 | SW415-ND
 |  |  |  |  |  |  |  |  |  |  | SUBTOTAL: | $41.00
Physical Items
1 | - | - | Miguel (3D printed) | - | PLA+ | - | Inner Door Mount | - |  |  | $0.26 | $0.26
1 | - | - | Miguel (3D printed) | - | PLA+ | - | Lock Plate Long | - |  |  | $0.32 | $0.32
1 | - | - | Miguel (3D printed) | - | PLA+ | - | Lock Cover | - |  |  | $0.32 | $0.32
1 | - | - | Miguel (3D printed) | - | PLA+ | - | Frame | - |  |  | $1.25 | $1.25
1 | - | - | Miguel (3D printed) | - | PLA+ | - | Battery PCB Frame | - |  |  | $1.22 | $1.22
1 | - | - | Miguel (3D printed) | - | PLA+ | - | Battery Cover | - |  |  | $0.21 | $0.21
1 | - | - | Miguel (3D printed) | - | PLA+ | - | Battery | - |  |  | $0.90 | $0.90
1 | - | - | Miguel (3D printed) | - | PLA+ | - | Cover | - |  |  | $0.76 | $0.76
1 | - | - | Miguel (3D printed) | - | PLA+ | - | Override | - |  |  | $0.28 | $0.28
12 | - | - | - | M3 Threaded Heatset Inserts | - | - | - | Amazon |  | https://www.amazon.com/gp/product/B087NBYF65 | $0.11 | $1.27
8 |  |  |  | M3x6 | Flat Head Screw |  |  | Amazon |  | https://www.amazon.com/gp/product/B07DDFR9Y3 | $0.09 | $0.72
4 |  |  |  | M3x8 | Flat Head Screw |  |  | Amazon |  | https://www.amazon.com/gp/product/B07DDFR9Y3 | $0.09 | $0.36
4 |  |  |  | M3x30 | Flat Head Screw |  |  | Amazon |  | https://www.amazon.com/gp/product/B07DDFR9Y3 | $0.09 | $0.36
 |  |  |  |  |  |  |  |  |  |  | SUBTOTAL: | $8.23
 |  |  |  |  |  |  |  |  |  |  | TOTAL COST | $49.23
VERSION INFO
Rev | Date | Notes
1.0r0 | 2020-11-11 | Initial BOM. Imported from Eagle and John's google sheet
1.0r1 | 2020-11-17 | Verifying component parts and footprints to match distributor sizes. Replaced Eagle button with button spec'd here.
1.0r3 | 2020-12-01 | Added 100nF Capacitor missing
1.0r4 | 2020-12-08 | Final Revision including Physical items and batteries
1.0r5 | 2021-01-07 | Added R11 for the pullup for the push to exit button
 | Total Run Costs | ~ $ 304.99
