PDXECE411T12/ECE411-Project/3D CAD/Cura Projects/UM3E_LockCoverLongThinner.3mf

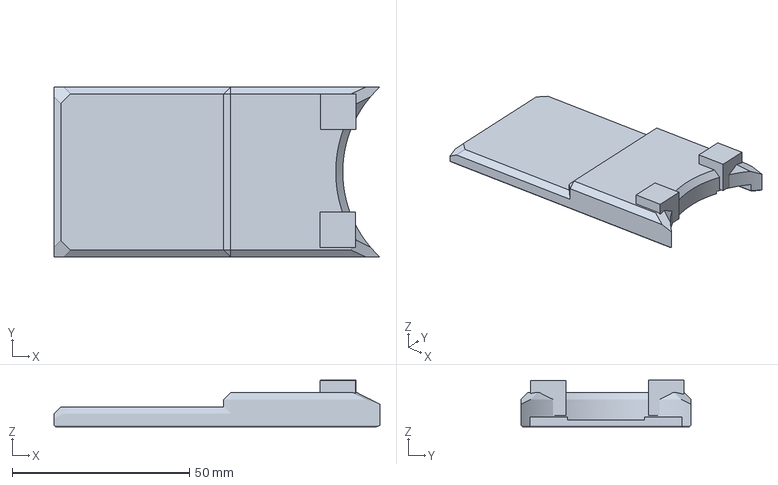
[picture p62: CAD file, 2020-12-09]
3D CAD/Cura Projects/UM3E_LockCoverLongThinner.3mf
92.0 x 48.0 x 13.2 mm
