PDXECE411T12/ECE411-Project/3D CAD/STLs/LockCoverLongThinThreadedInsert.stl

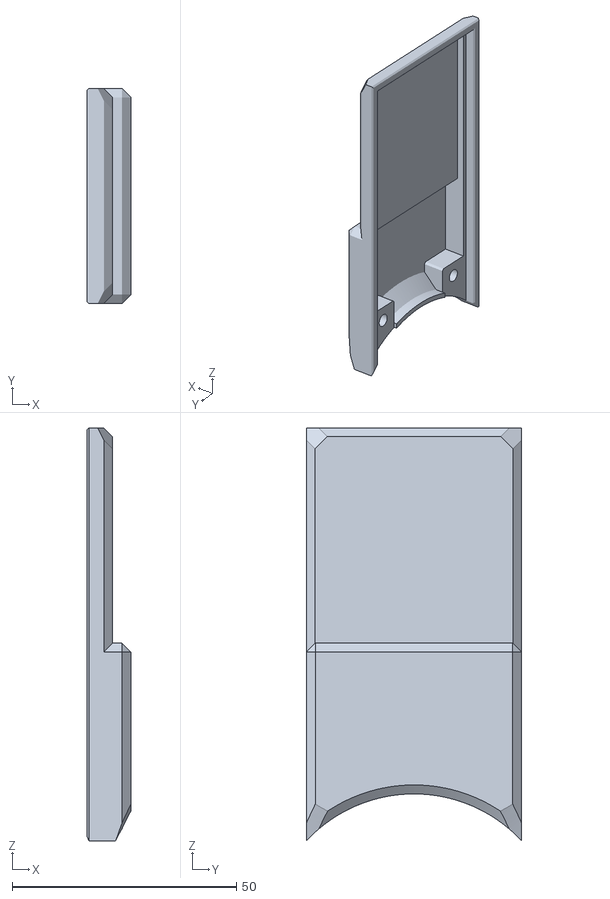
[picture p63: CAD file, 2021-01-09]
3D CAD/STLs/LockCoverLongThinThreadedInsert.stl
9.75 x 48.0 x 92.0
