PDXECE411T12/ECE411-Project/3D CAD/STLs/FrameThreadedInserts.stl

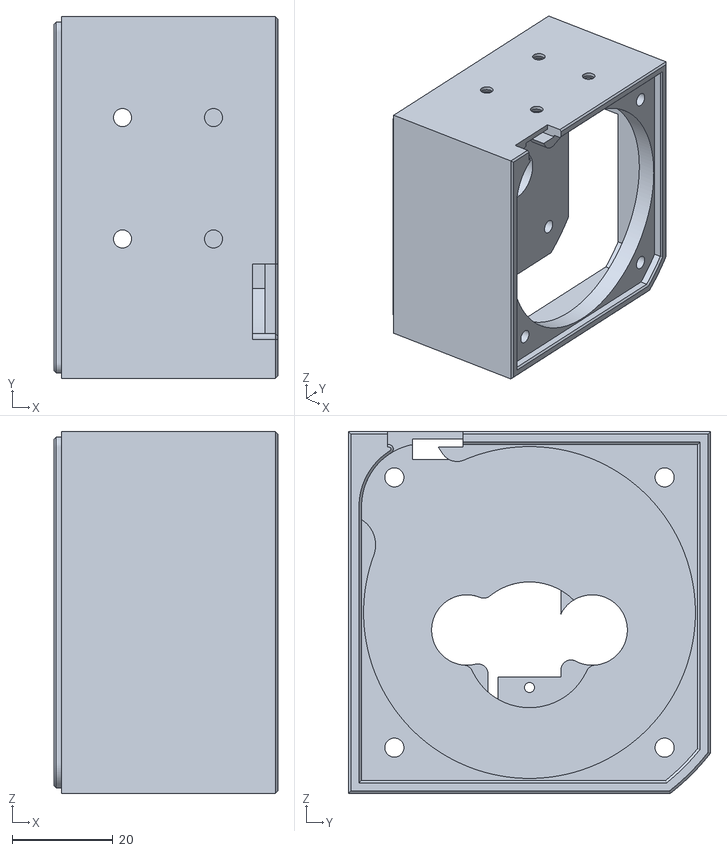
[picture p64: CAD file, 2021-01-09]
3D CAD/STLs/FrameThreadedInserts.stl
44.5 x 72.0 x 72.0
