PDXECE411T12/ECE411-Project/3D CAD/Cura Projects/Battery.3mf

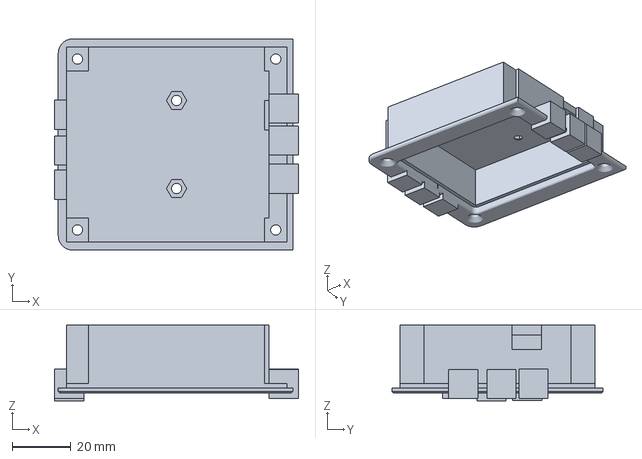
[picture p65: CAD file, 2020-11-29]
3D CAD/Cura Projects/Battery.3mf
83.2 x 72.0 x 25.7 mm
