PDXECE411T12/ECE411-Project/3D CAD/Cura Projects/UM3E_LockCoverLong.3mf

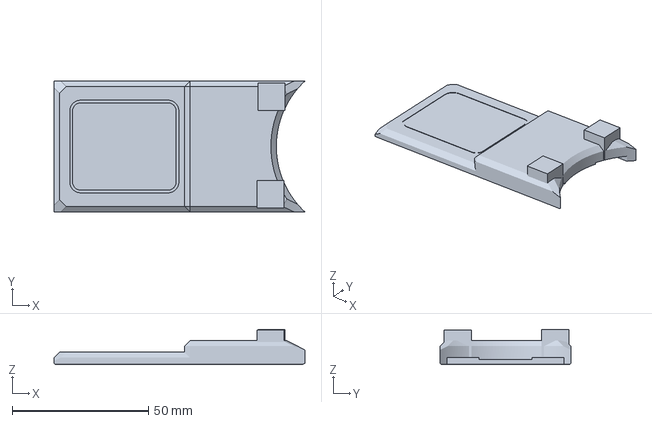
[picture p66: CAD file, 2020-11-29]
3D CAD/Cura Projects/UM3E_LockCoverLong.3mf
92.0 x 48.0 x 12.9 mm
