PDXECE411T12/ECE411-Project/3D CAD/STLs/FrameCombined.stl

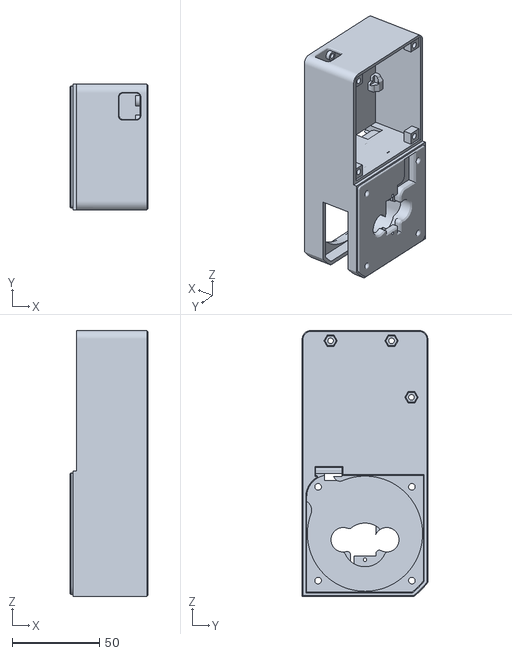
[picture p67: CAD file, 2021-01-09]
3D CAD/STLs/FrameCombined.stl
44.5 x 72.0 x 152.4
