PDXECE411T12/ECE411-Project/3D CAD/Cura Projects/UM3E_Frame.3mf

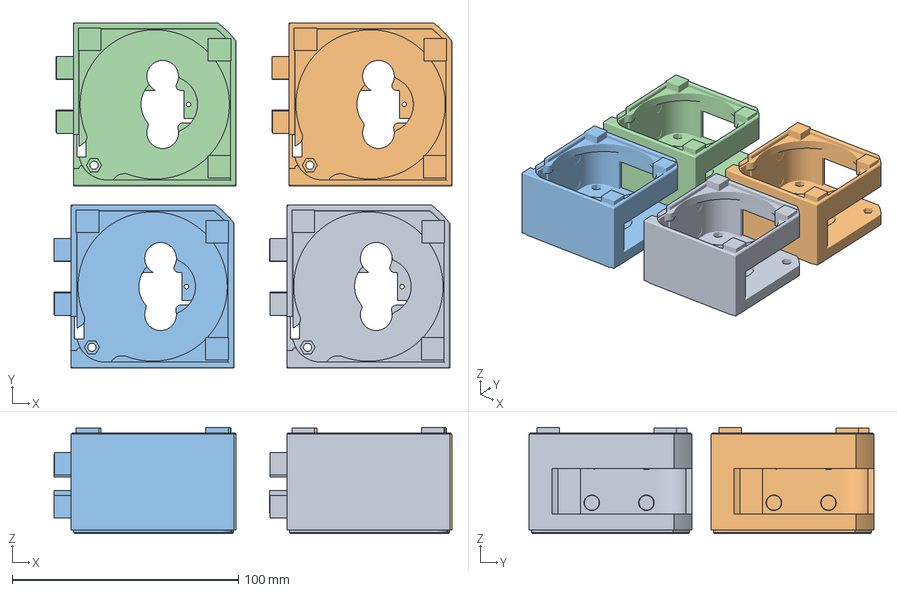
[picture p68: CAD file, 2020-11-29]
3D CAD/Cura Projects/UM3E_Frame.3mf
176.0 x 152.5 x 46.9 mm
Frame.stl(3)
Frame.stl(1)
Frame.stl(2)
Frame.stl(4)
