PDXECE411T12/ECE411-Project/3D CAD/STLs/Override90deg.stl

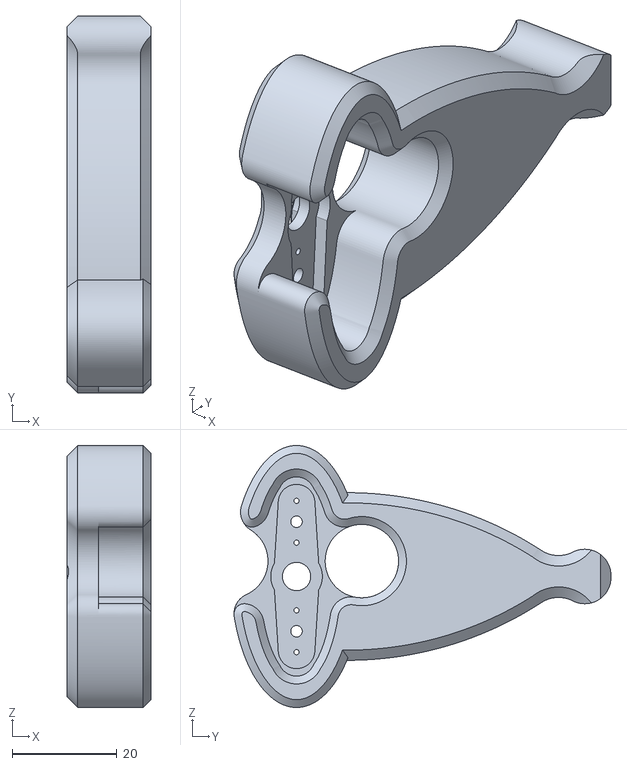
[picture p69: CAD file, 2021-01-09]
3D CAD/STLs/Override90deg.stl
16.0 x 71.9 x 50.0
