PDXECE411T12/ECE411-Project/3D CAD/STLs/CoverThin.stl

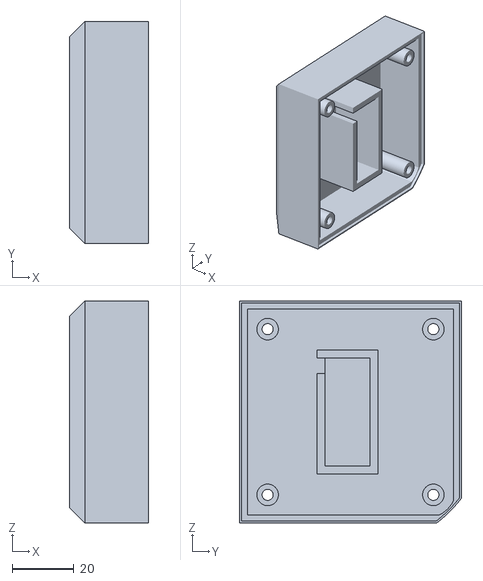
[picture p70: CAD file, 2020-11-29]
3D CAD/STLs/CoverThin.stl
25.7 x 72.0 x 72.0
