PDXECE411T12/ECE411-Project/3D CAD/STLs/Inner Door MountLessMaterial.stl

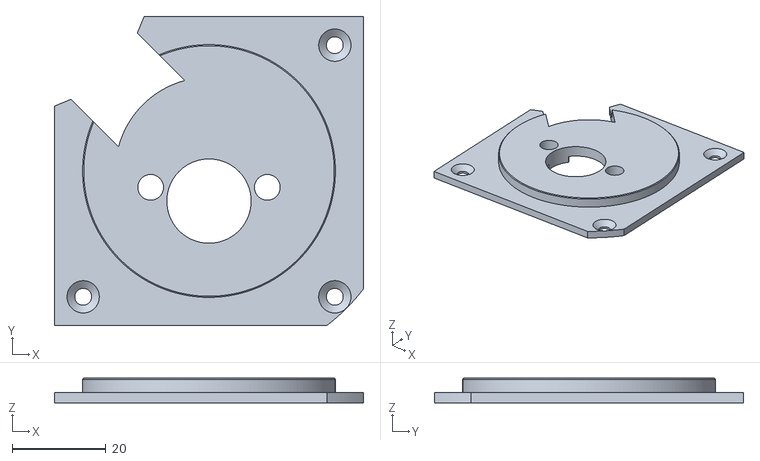
[picture p71: CAD file, 2020-11-29]
3D CAD/STLs/Inner Door MountLessMaterial.stl
66.0 x 66.0 x 5.25
