PDXECE411T12/ECE411-Project/3D CAD/STLs/CoverThinButton.stl

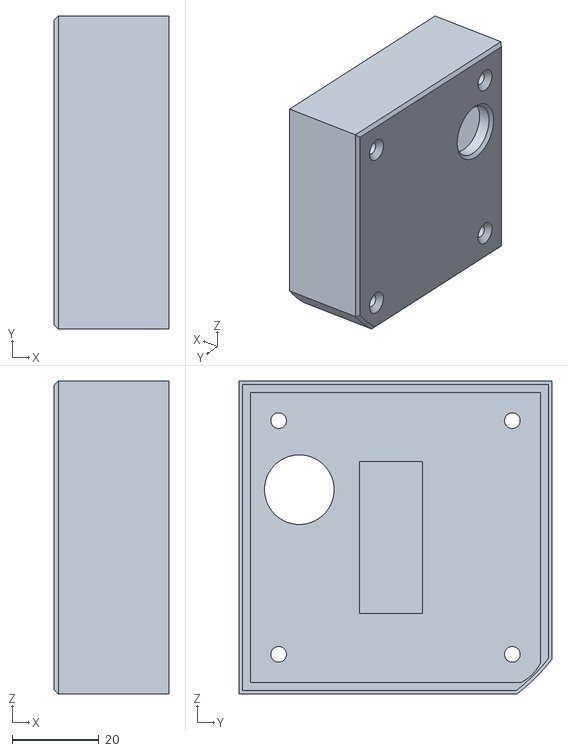
[picture p72: CAD file, 2020-11-29]
3D CAD/STLs/CoverThinButton.stl
26.5 x 72.0 x 72.0
