PDXECE411T12/ECE411-Project/3D CAD/STLs/Battery Cover.stl

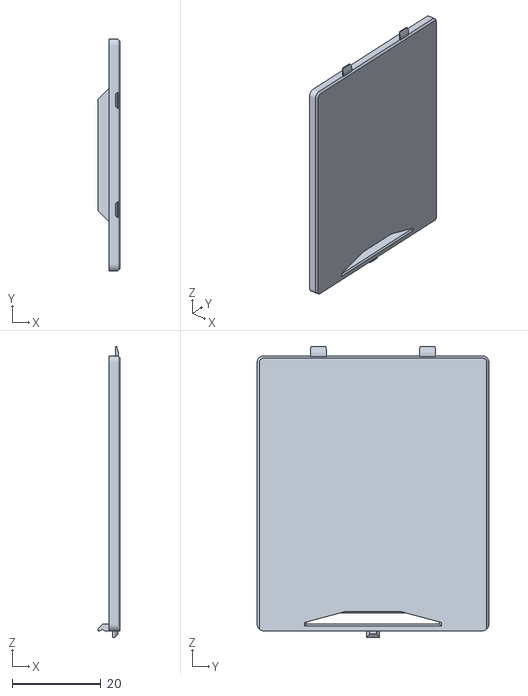
[picture p73: CAD file, 2020-11-29]
3D CAD/STLs/Battery Cover.stl
5.00 x 52.2 x 65.6
