PDXECE411T12/ECE411-Project/3D CAD/STLs/Battery PCB FrameThreadedInserts.stl

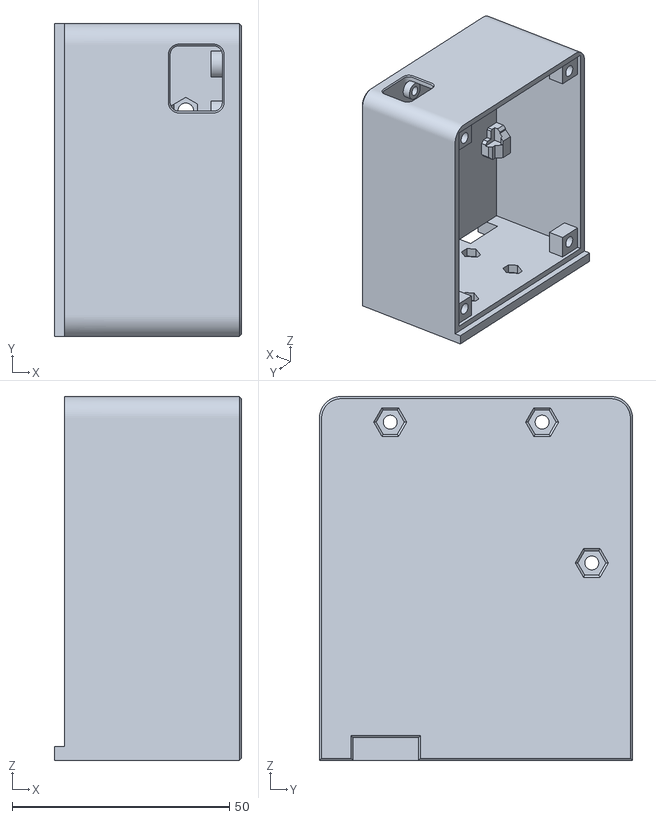
[picture p74: CAD file, 2020-11-29]
3D CAD/STLs/Battery PCB FrameThreadedInserts.stl
43.0 x 72.0 x 83.7
