PDXECE411T12/ECE411-Project/3D CAD/STLs/LockPlateLong.stl

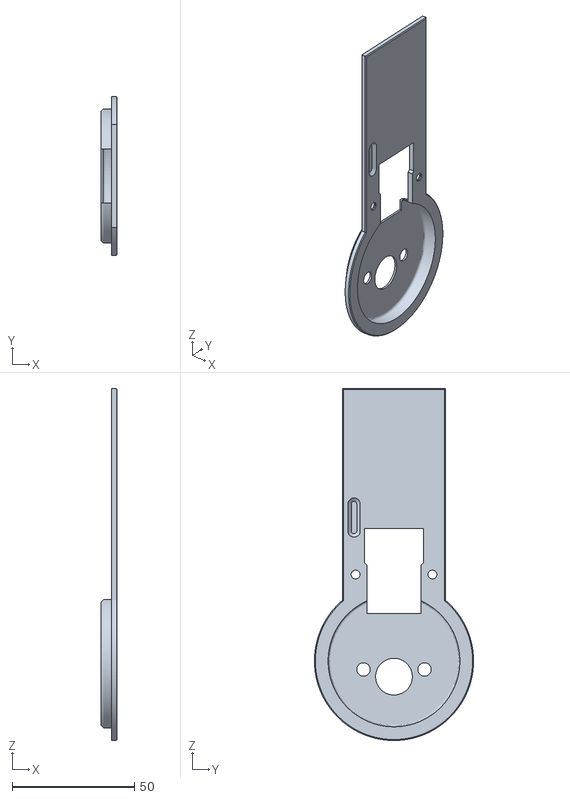
[picture p75: CAD file, 2020-11-29]
3D CAD/STLs/LockPlateLong.stl
6.65 x 65.0 x 143.7
