PDXECE411T12/ECE411-Project/3D CAD/STLs/DoorCap.stl

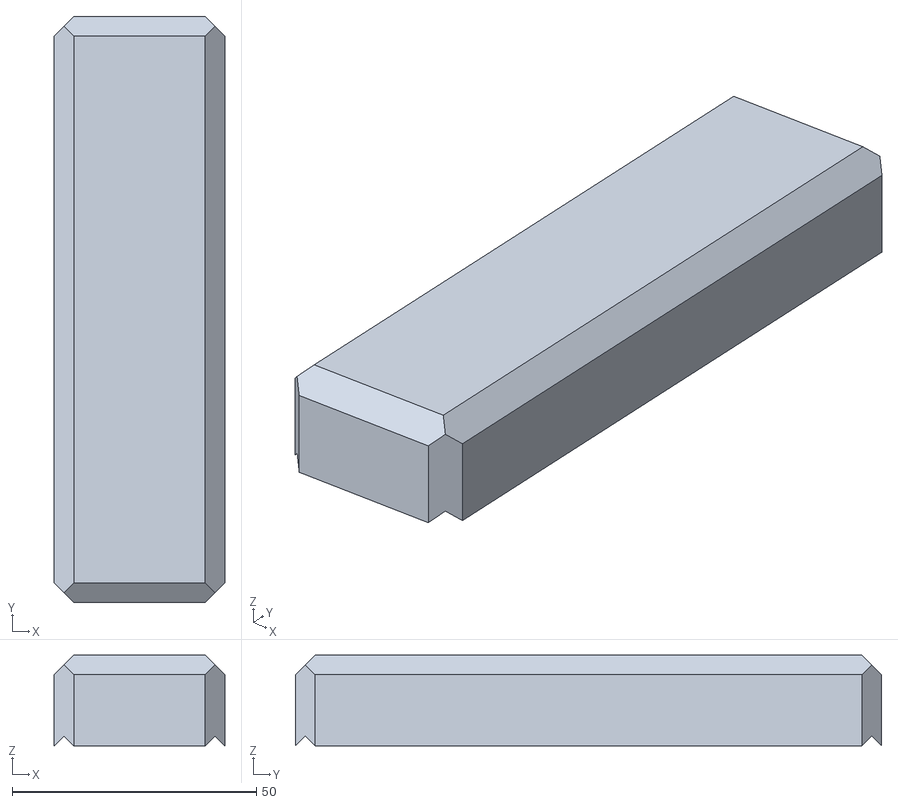
[picture p76: CAD file, 2020-11-29]
3D CAD/STLs/DoorCap.stl
34.9 x 120.0 x 18.6
