PDXECE411T12/ECE411-Project/3D CAD/STLs/Override.stl

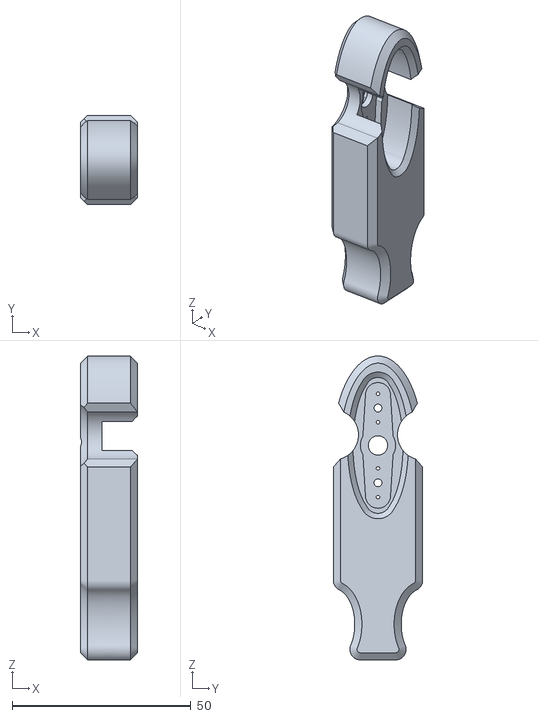
[picture p77: CAD file, 2020-11-17]
3D CAD/STLs/Override.stl
16.0 x 25.0 x 85.0
