PDXECE411T12/ECE411-Project/3D CAD/STLs/LockCoverShortSolderWires.stl

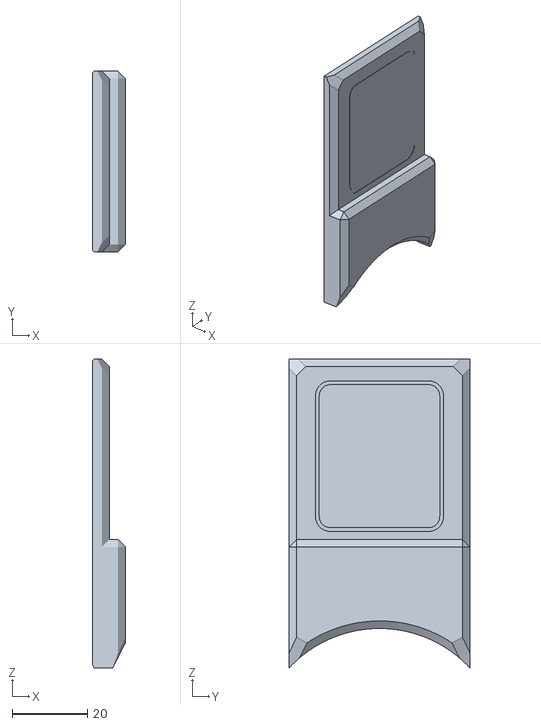
[picture p78: CAD file, 2020-11-17]
3D CAD/STLs/LockCoverShortSolderWires.stl
8.75 x 48.0 x 82.0
