PDXECE411T12/ECE411-Project/3D CAD/STLs/Door.stl

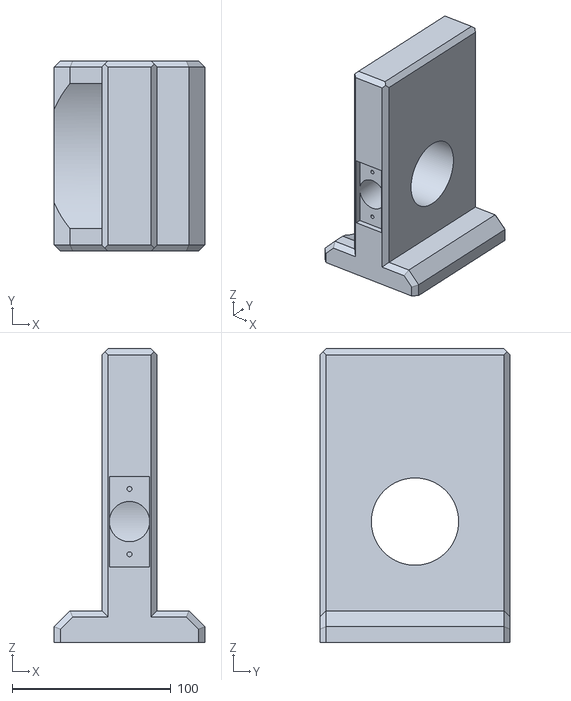
[picture p79: CAD file, 2020-11-17]
3D CAD/STLs/Door.stl
94.9 x 120.0 x 185.3
