PDXECE411T12/ECE411-Project/3D CAD/STLs/LockPlateShort.stl

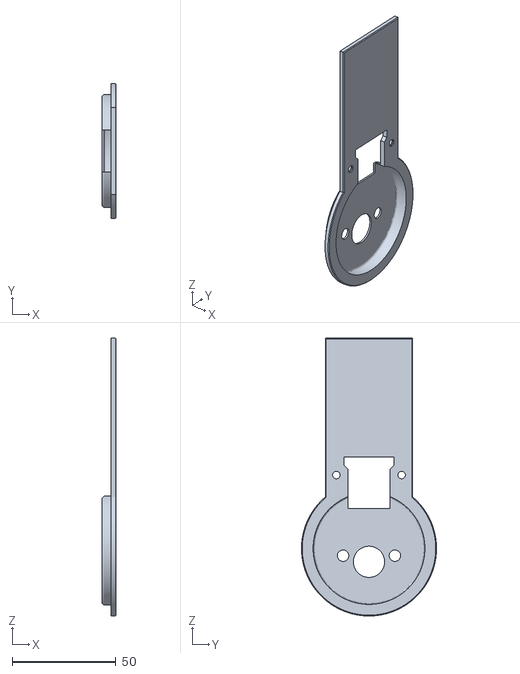
[picture p80: CAD file, 2020-11-17]
3D CAD/STLs/LockPlateShort.stl
6.65 x 65.0 x 133.7
