PDXECE411T12/ECE411-Project/3D CAD/STLs/Cover.stl

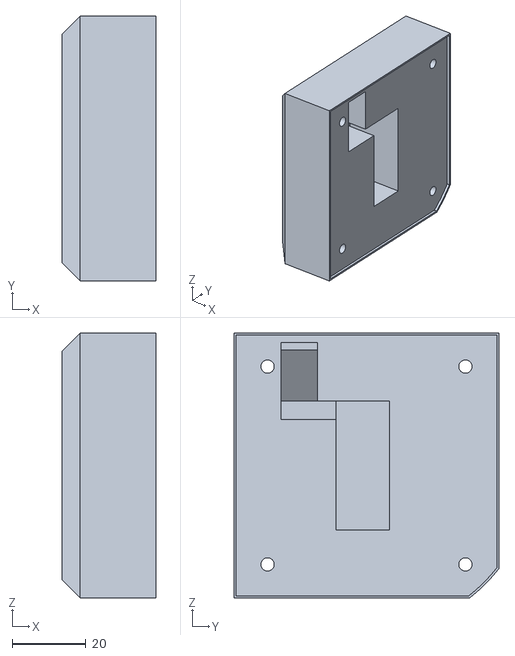
[picture p81: CAD file, 2020-11-17]
3D CAD/STLs/Cover.stl
25.7 x 72.0 x 72.0
