PDXECE411T12/ECE411-Project/3D CAD/STLs/Inner Door Mount.stl

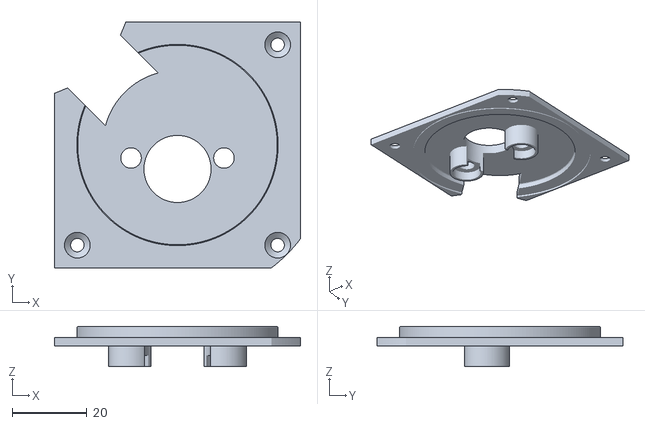
[picture p82: CAD file, 2020-11-17]
3D CAD/STLs/Inner Door Mount.stl
66.0 x 66.0 x 10.8
