PDXECE411T12/ECE411-Project/3D CAD/STLs/Battery.stl

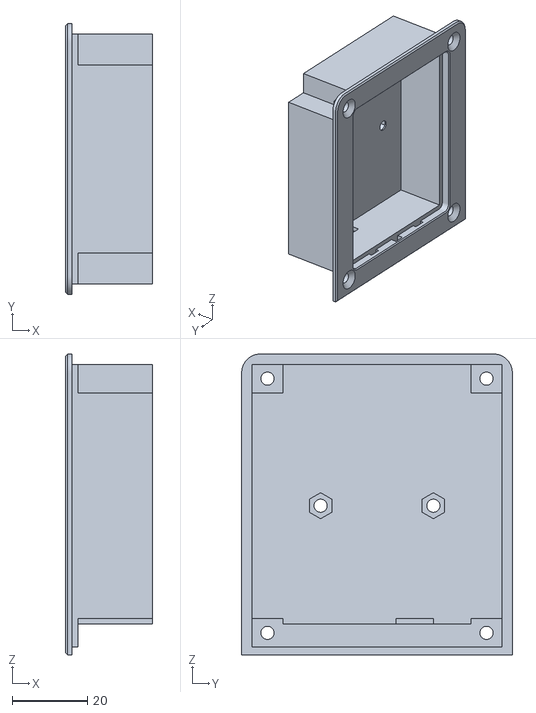
[picture p83: CAD file, 2020-11-17]
3D CAD/STLs/Battery.stl
23.0 x 72.0 x 80.0
