PDXECE411T12/ECE411-Project/(list of files, cad)

Other CAD files:
3D CAD/Cura Projects/UM3E_LockCoverLongThin.3mf
3D CAD/STLs/LockCoverLongThinThreadedInsertPrusa.stl
3D CAD/STLs/LockCoverLongThin.stl
3D CAD/STLs/LockCoverLong.stl
3D CAD/STLs/FrameNuts.stl
