PDXECE411T12/ECE411-Project/3D CAD/Renders/Deadbolt_Model_Assembly_2020-Oct-16_01-24-04AM-000_CustomizedView5684227346_png.png

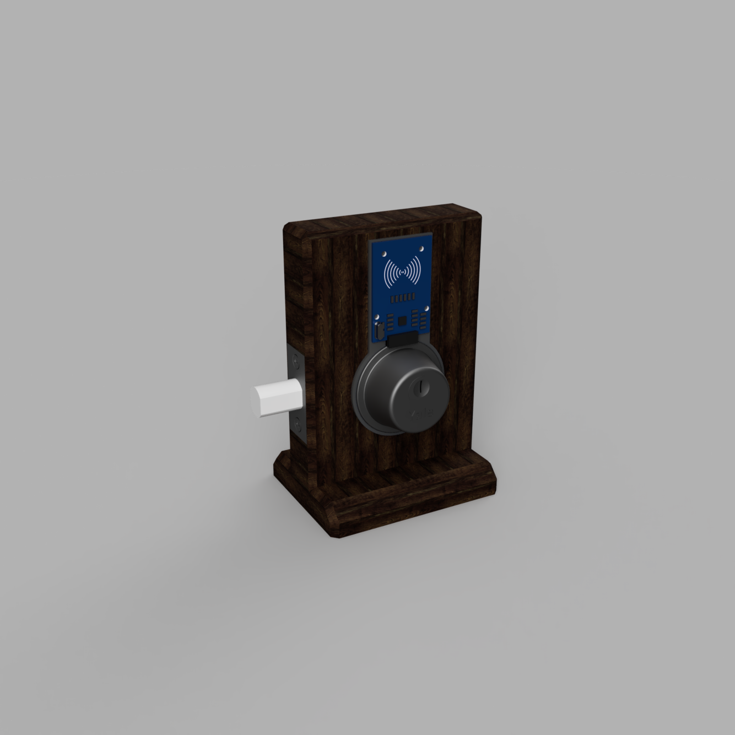
3D CAD/Renders/Deadbolt_Model_Assembly_2020-Oct-16_01-24-04AM-000_CustomizedView5684227346_png.png
