PDXECE411T12/ECE411-Project/3D CAD/Renders/Deadbolt_Model_Assembly_2021-Jan-09_03-48-09AM-000_CustomizedView38527390733.png

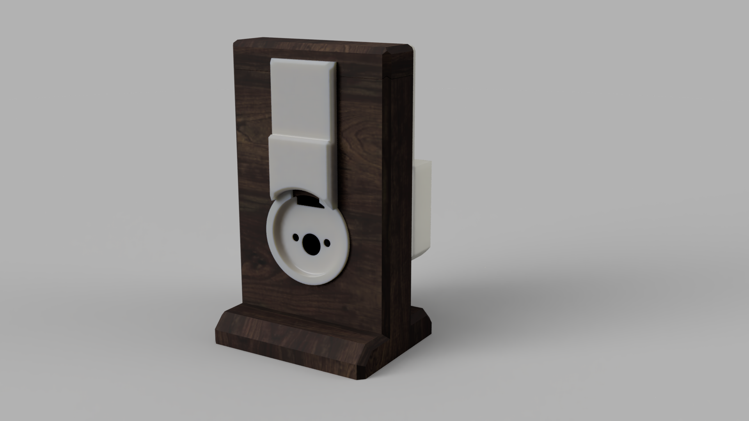
3D CAD/Renders/Deadbolt_Model_Assembly_2021-Jan-09_03-48-09AM-000_CustomizedView38527390733.png
