PDXECE411T12/ECE411-Project/3D CAD/Renders/Deadbolt_Model_Assembly_2021-Jan-09_03-50-12AM-000_CustomizedView14270805522.png

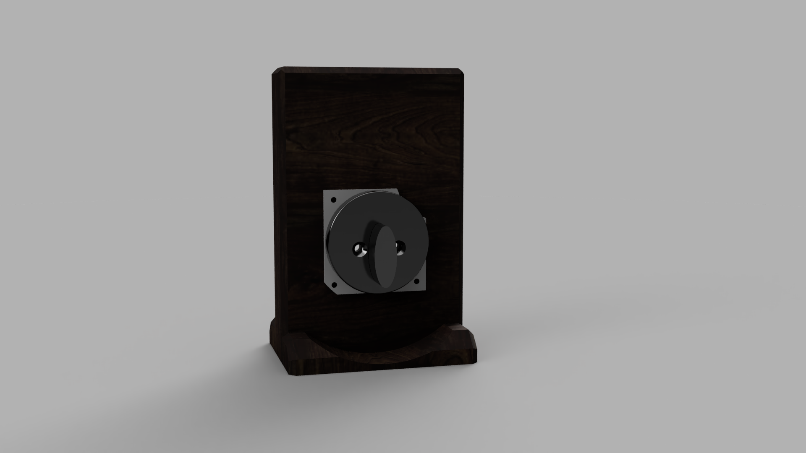
3D CAD/Renders/Deadbolt_Model_Assembly_2021-Jan-09_03-50-12AM-000_CustomizedView14270805522.png
