PDXECE411T12/ECE411-Project/Assembly Photos/PXL_20201205_074058242.jpg

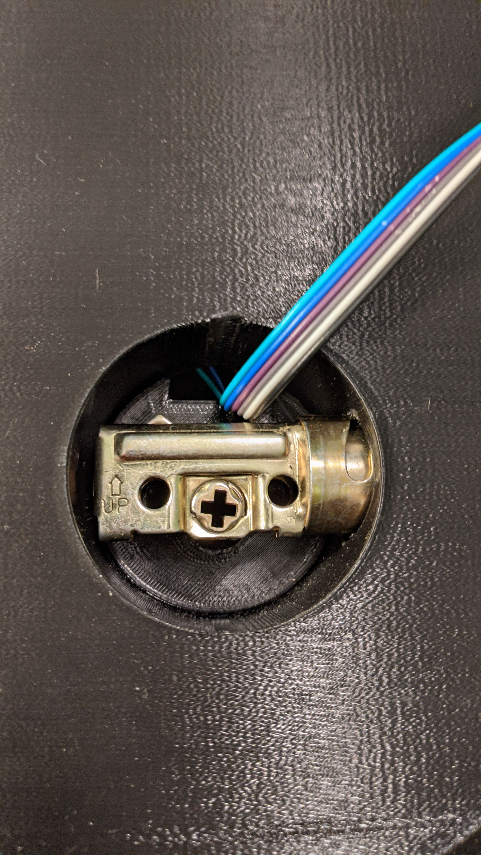
Assembly Photos/PXL_20201205_074058242.jpg
