PDXECE411T12/ECE411-Project/Assembly Photos/PXL_20201205_075310528.jpg

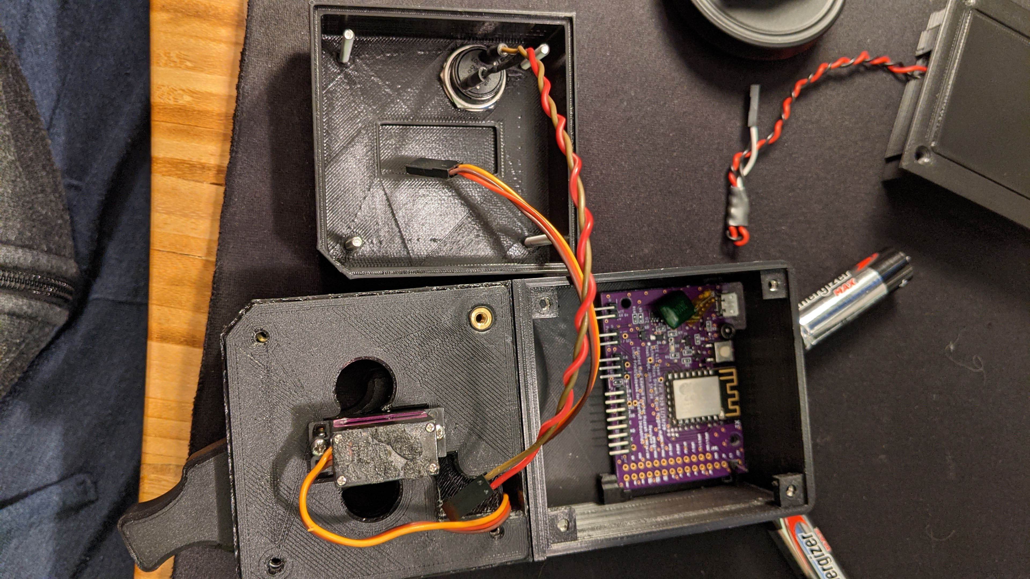
Assembly Photos/PXL_20201205_075310528.jpg
