PDXECE411T12/ECE411-Project/Assembly Photos/PXL_20201205_080011383.MP.jpg

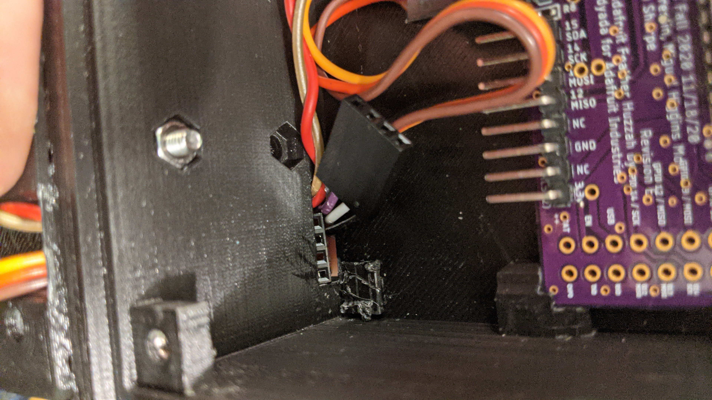
Assembly Photos/PXL_20201205_080011383.MP.jpg
