PDXECE411T12/ECE411-Project/Assembly Photos/PXL_20201205_081255402.MP.jpg

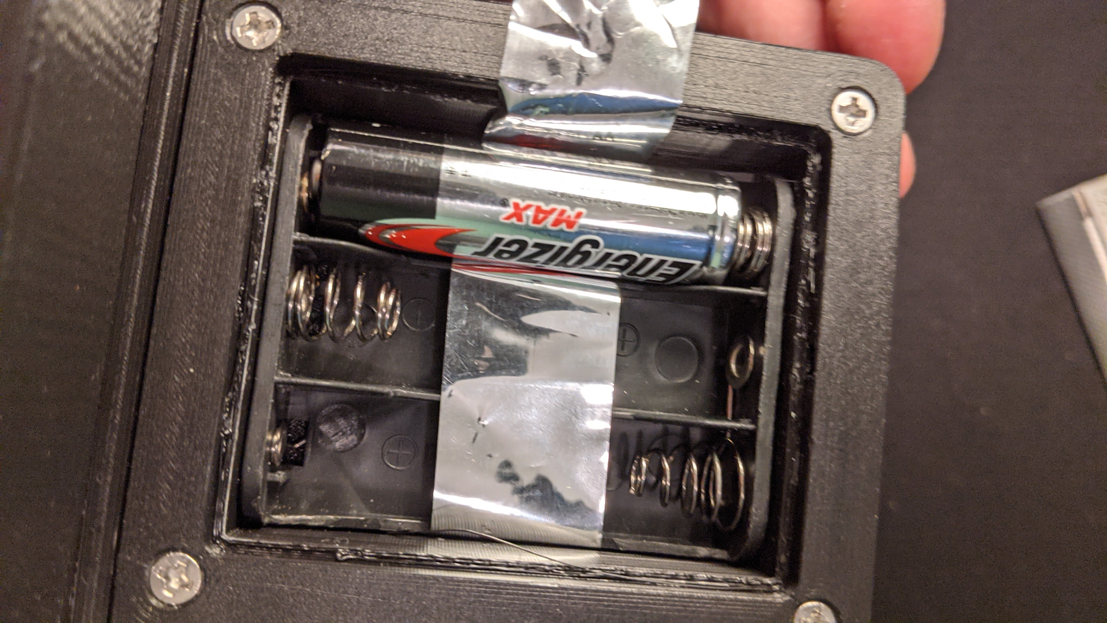
Assembly Photos/PXL_20201205_081255402.MP.jpg
