PDXECE411T12/ECE411-Project/Assembly Photos/PXL_20201205_082430585.MP.jpg

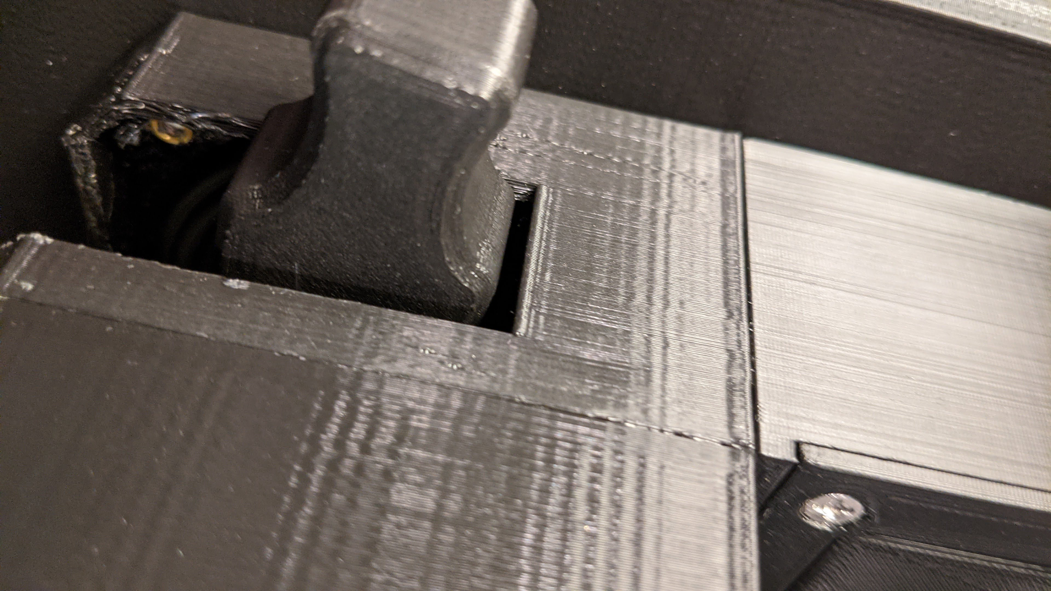
Assembly Photos/PXL_20201205_082430585.MP.jpg
