PDXECE411T12/ECE411-Project/Homework Deliverables/Practicum/imgs/DeadboltAssembly.png

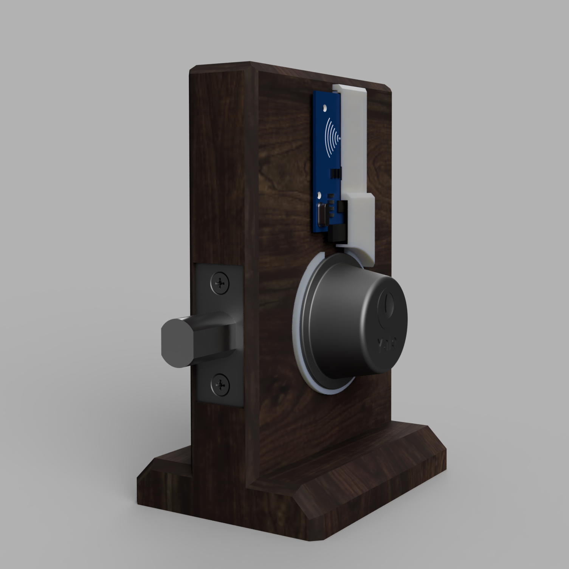
Homework Deliverables/Practicum/imgs/DeadboltAssembly.png
