PDXECE411T12/ECE411-Project/(commit log)

2020-10-15 Added folder
    Organizing and added Eagle empty project
    [untitled.sch]
2020-10-16 Added Homework 3 markdown
    [Deadbolt Model Assembly v8.f3z]
2020-10-19 Shortened Executive Summary section, edited marketing detail at bottom of market analysis, added arduino IDE to Design Specification List
2020-11-02 Init Eagle Schematic
    [ESP8266 RFID Schematic.brd, ESP8266 RFID Schematic.sch]
2020-11-02 HW4: Add Schematic
2020-11-08 Rough Schematic layout of prototype board
    [ESP8266 RFID Schematic.brd, ESP8266 RFID Schematic.sch]
2020-11-08 File clean up and organizing
    [ESP8266 RFID Schematic.brd, ESP8266 RFID Schematic.sch, untitled.sch]
2020-11-08 Placed derivative work under forked repo under the correct license
    [ESP8266 RFID Schematic.brd, ESP8266 RFID Schematic.sch]
2020-11-12 HW6: BoM
2020-11-17 Updated near final CAD and exported STLs
    [Battery Cover.stl, Battery PCB Frame.stl, Battery.stl, Cover.stl, Deadbolt Model Assembly v8.f3z, Door.stl, Frame.stl, Inner Door Mount.stl]
2020-11-18 Design review notes
    [Frame.stl]
2020-11-29 3D CAD Final Edits
    [Battery Cover.stl, Battery PCB Frame.stl, Battery.3mf, CoverThin.stl, CoverThinButton.stl, DoorCap.stl, Inner Door Mount New.stl, LockCoverLong.stl]
2020-12-09 Updated CAD Files
    [LockCoverLongThin.stl, UM3E_LockCoverLongThinner.3mf]
2020-12-09 Update BOM
2021-01-09 Added renders, clarified STL names, added pictures
    [BOM.xlsx, Battery PCB Frame.stl, Battery PCB FrameThreadedInserts.stl, Frame.stl, FrameCombined.stl, FrameNuts.stl, FrameThreadedInserts.stl, Inner Door Mount New.stl]
